JHorwitz1011/F.R.E.T.-Board/boards/shield/v1/output/v3/v1.png

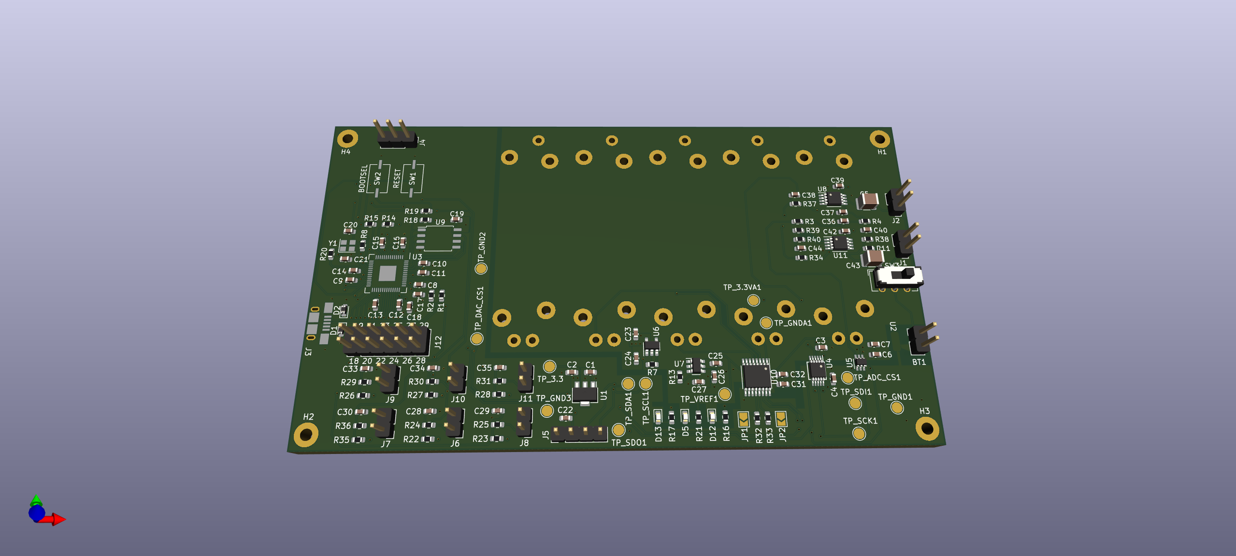
boards/shield/v1/output/v3/v1.png
