JHorwitz1011/F.R.E.T.-Board/README.md

# F.R.E.T.-Board

## Fall '23 Senior Project

Jim Horwitz, Julia Brubach, Peter Buglewicz
