JHorwitz1011/F.R.E.T.-Board/code/examples/filtering/fullFilterBoth.png

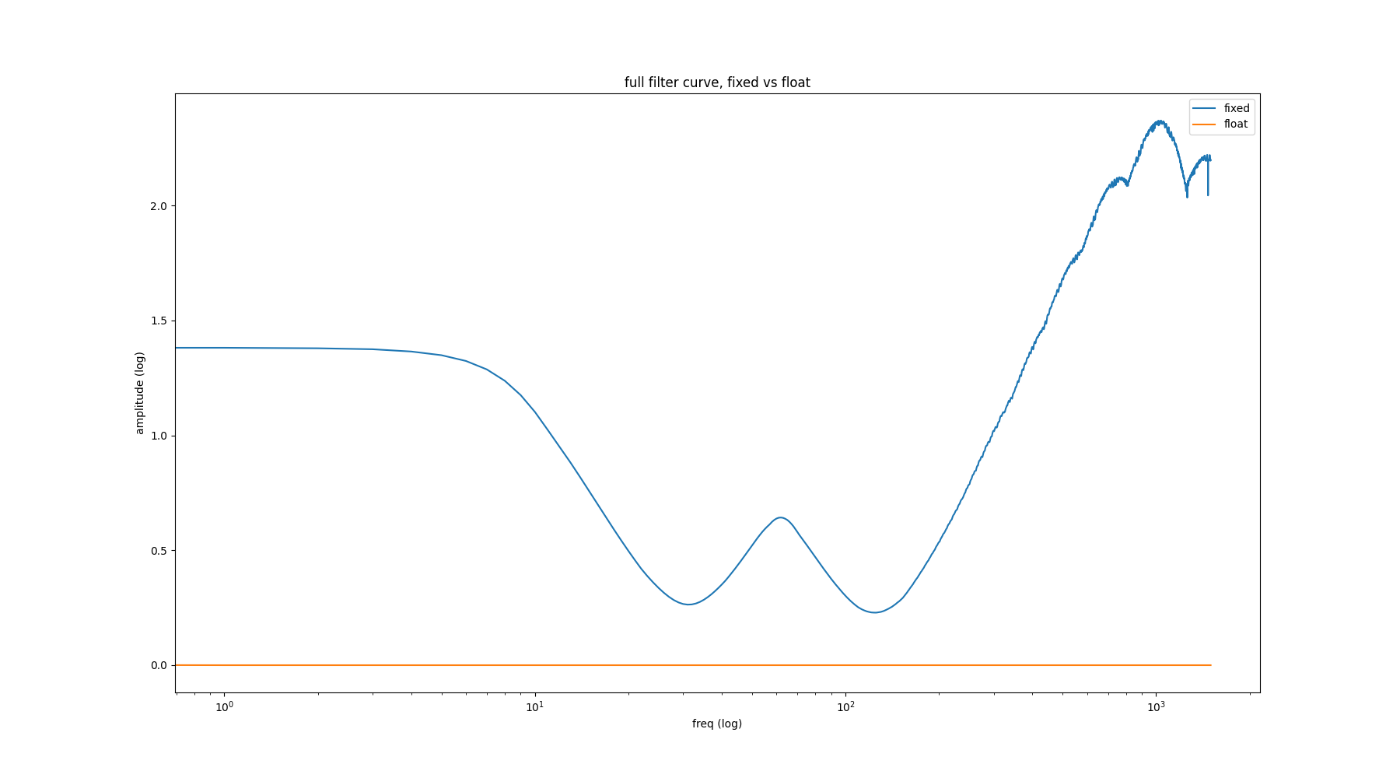
code/examples/filtering/fullFilterBoth.png
