JHorwitz1011/F.R.E.T.-Board/code/examples/filtering/fullFilterFixed.png

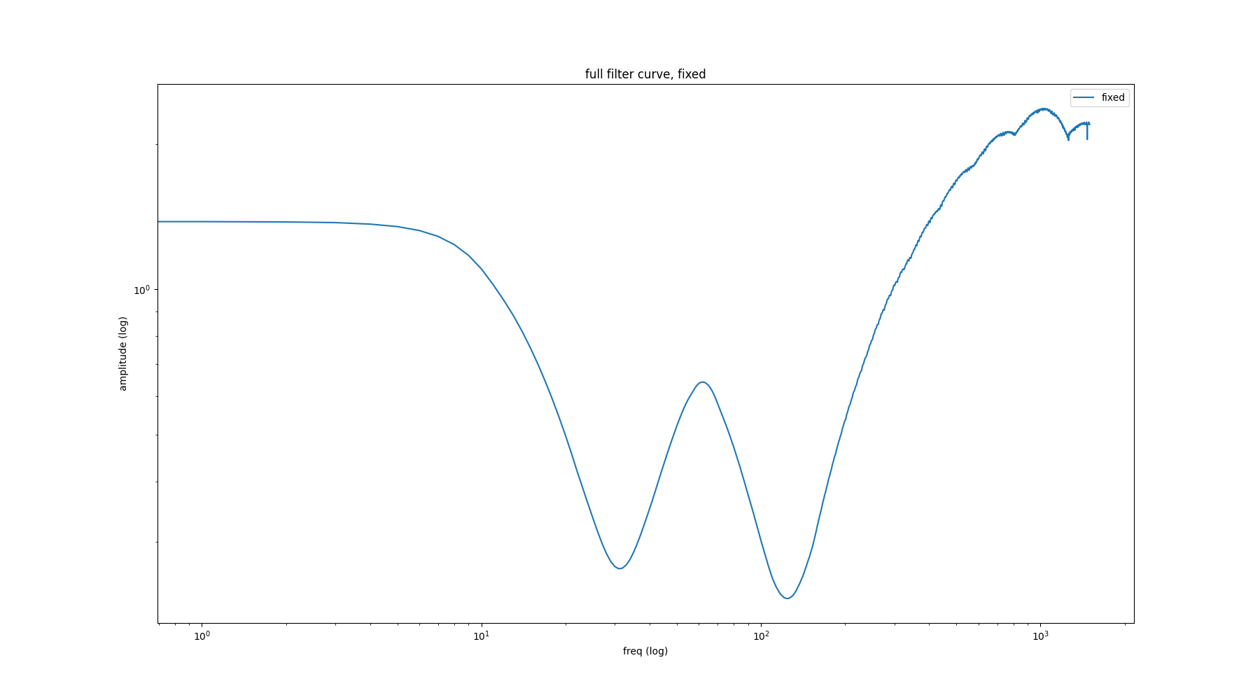
code/examples/filtering/fullFilterFixed.png
