JHorwitz1011/F.R.E.T.-Board/code/examples/filtering/fullFilterFloat.png

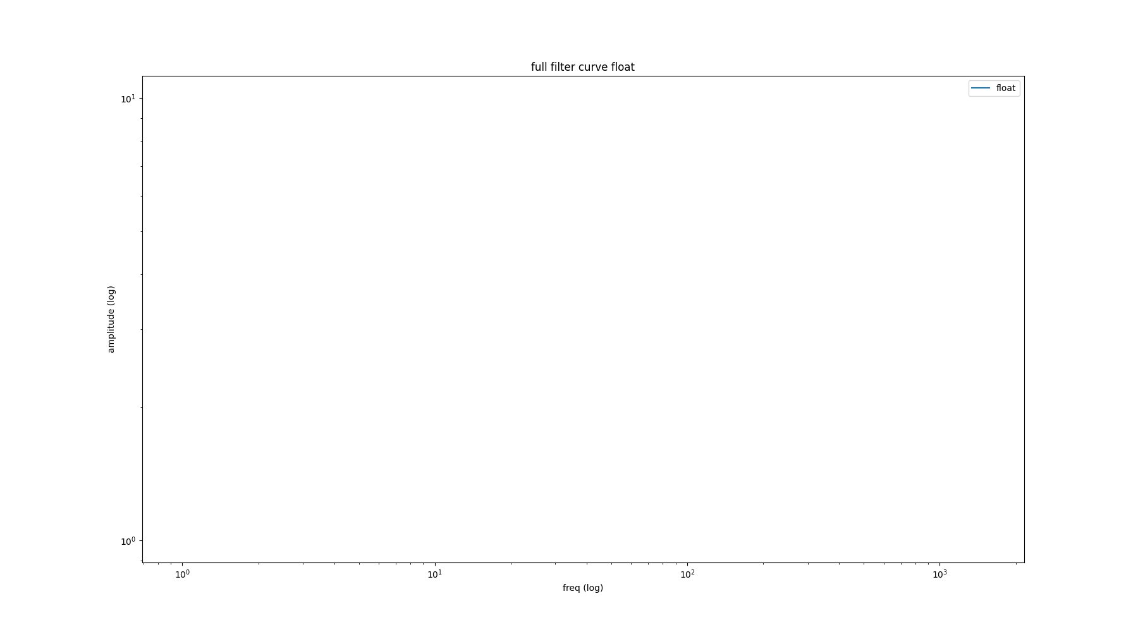
code/examples/filtering/fullFilterFloat.png
