JHorwitz1011/F.R.E.T.-Board/code/examples/filtering/individualResponsesBoth.png

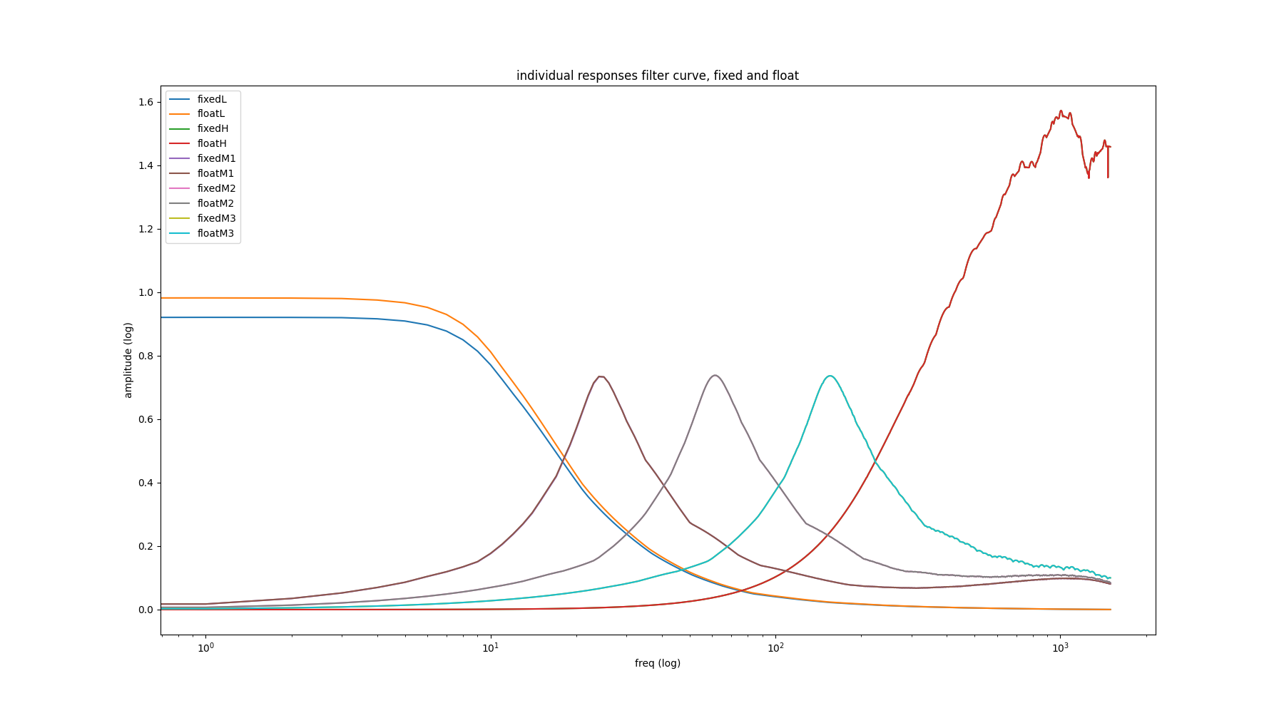
code/examples/filtering/individualResponsesBoth.png
