JHorwitz1011/F.R.E.T.-Board/code/examples/filtering/individualResponsesFixed.png

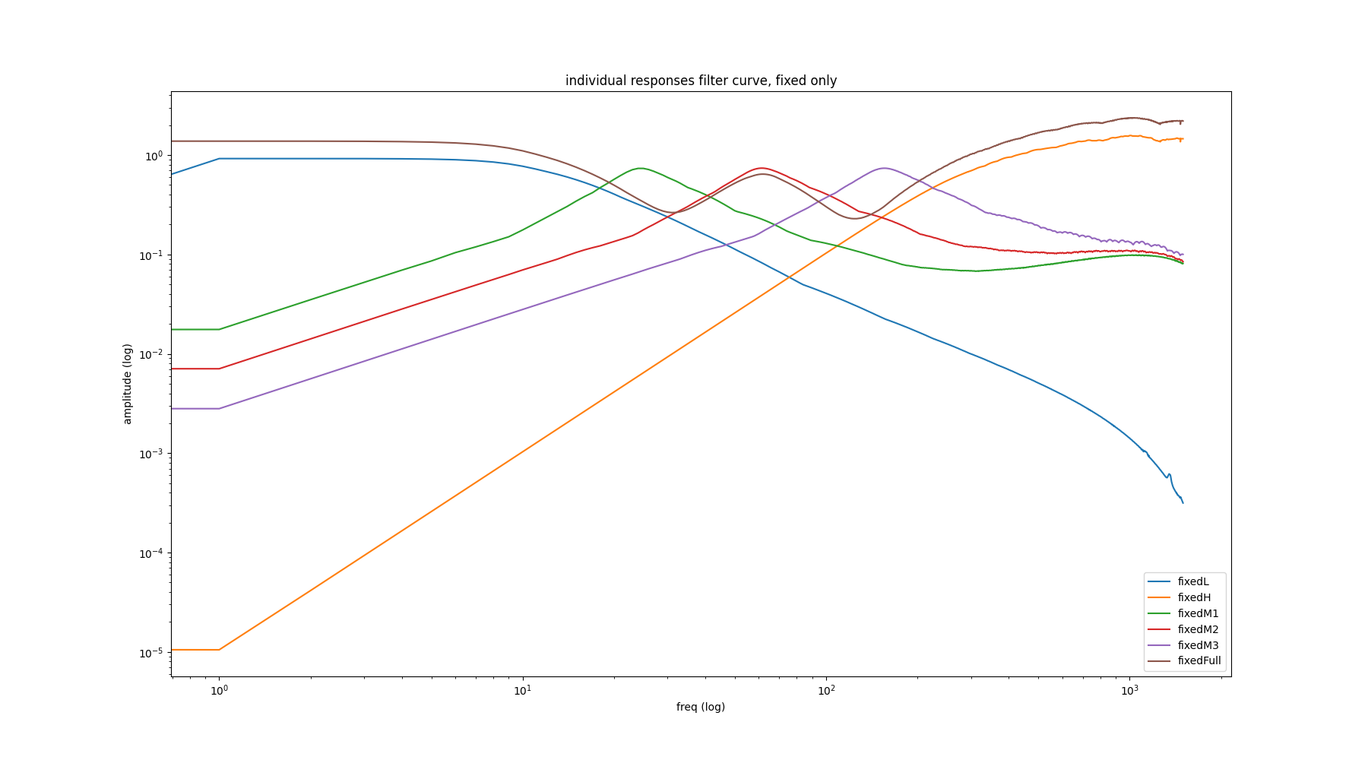
code/examples/filtering/individualResponsesFixed.png
