JHorwitz1011/F.R.E.T.-Board/code/examples/filtering/individualResponsesFloat.png

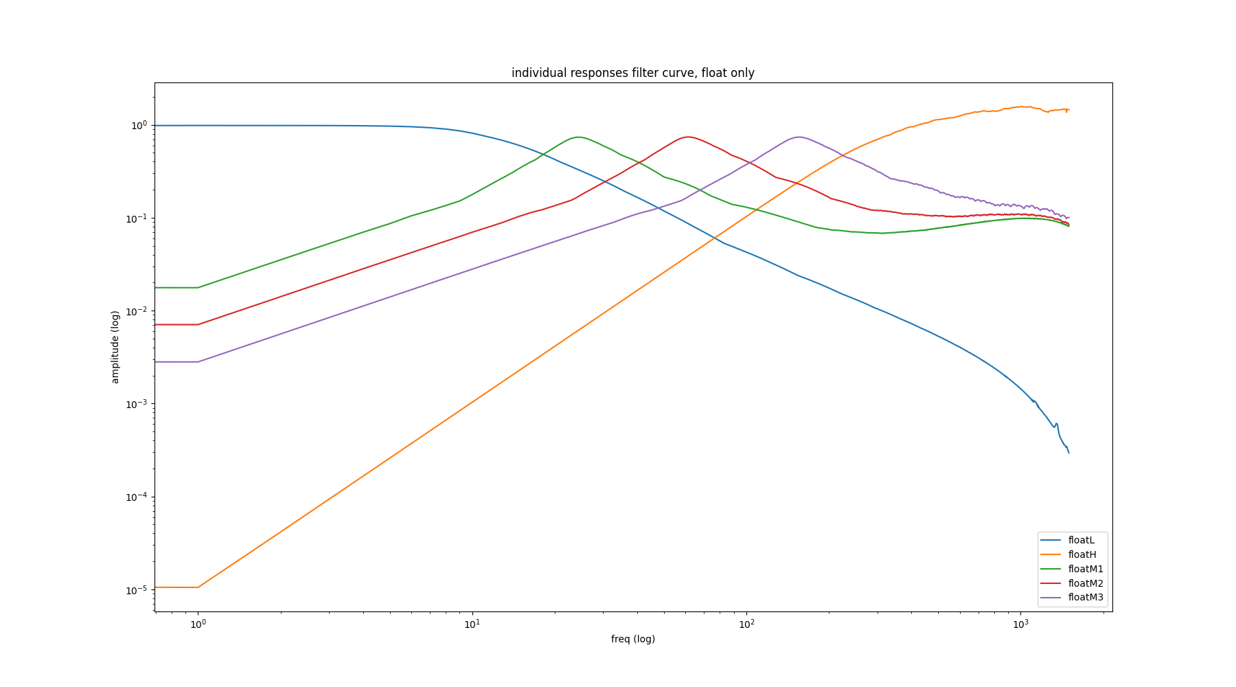
code/examples/filtering/individualResponsesFloat.png
