JHorwitz1011/F.R.E.T.-Board/boards/shield/v1/output/v3/v1.pdf

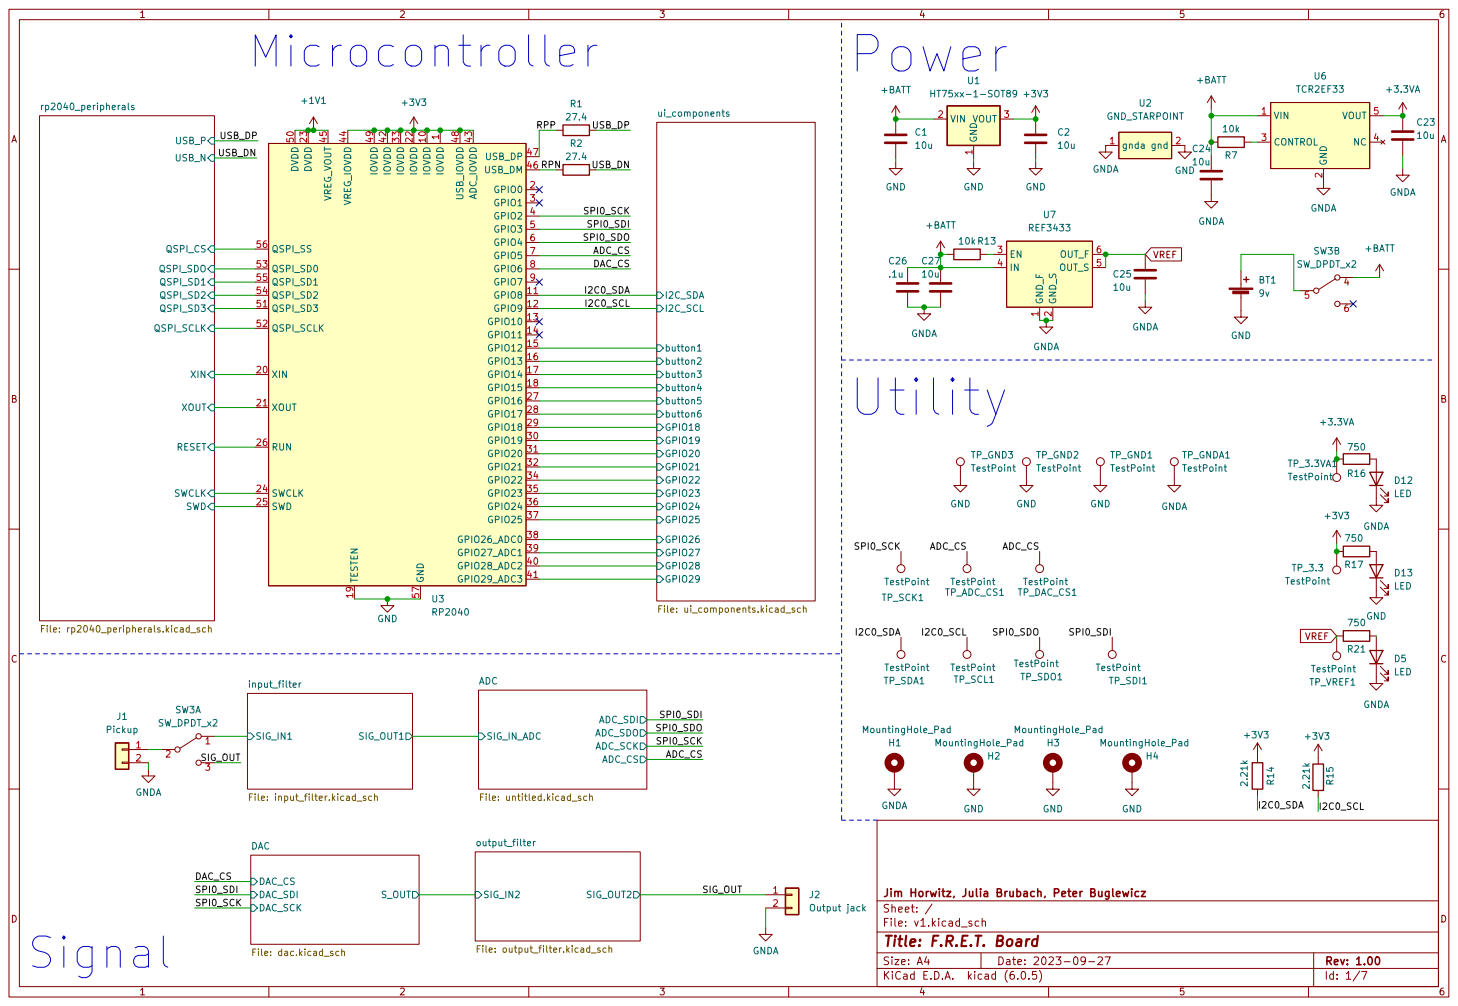
[picture p8: page 1]

2 CONTROL 3 NC 4 VOUT 5 U6 TCR2EF33 GNDA D13
+BATTR7

1 IOVDD 10 GPIO8 11 GPIO9 12 GPIO10 13 GPIO11 14 GPIO12 15 GPIO13 16 GPIO14 17 GPIO15 18 TESTEN 19 GPIO0 2 XIN 20 XOUT 21 IOVDD 22 DVDD 23 SWCLK 24 SWD 25 RUN 26 GPIO16 27 GPIO17 28 GPIO18 29 GPIO1 3 GPIO19 30 GPIO20 31 GPIO21 32 IOVDD 33 GPIO22 34 GPIO23 35 GPIO24 36 GPIO25 37 GPIO26_ADC0 38 GPIO27_ADC1 39 GPIO2 4 GPIO28_ADC2 40 GPIO29_ADC3 41 IOVDD 42 ADC_IOVDD 43 VREG_IOVDD 44 VREG_VOUT 45 USB_DM 46 USB_DP 47 USB_IOVDD 48 IOVDD 49 GPIO3 5 DVDD 50 QSPI_SD3 51 QSPI_SCLK 52 QSPI_SD0 53 QSPI_SD2 54 QSPI_SD1 55 QSPI_SS 56 GND 57 GPIO4 6 GPIO5 7 GPIO6 8 GPIO7 9 U3RP2040 +3V3 TP_3.3VA1 TestPoint VREF VREF ADC_CS

QSPI_SD2 QSPI_SD3 QSPI_SD1 QSPI_SCLK QSPI_CS
SWCLK RESET XOUT XIN QSPI_SDO

File: v1.kicad_sch Sheet: / Jim Horwitz, Julia Brubach, Peter Buglewicz SWD

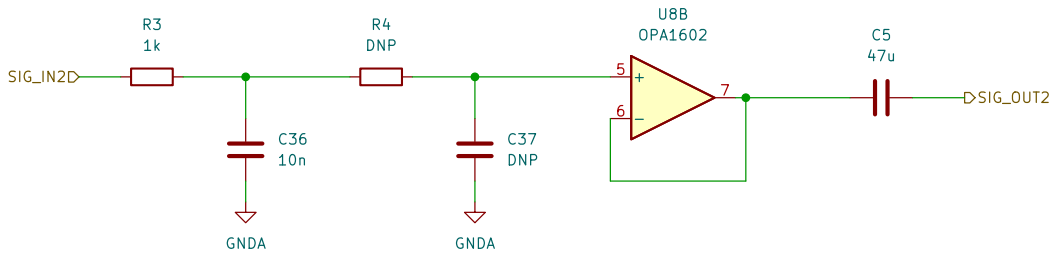
[picture p9: page 2]

Jim Horwitz, Julia Brubach, Peter Buglewicz
Sheet: /output_filter/
File: output_filter.kicad_sch
Id: 2/7 Title: F.R.E.T. Board

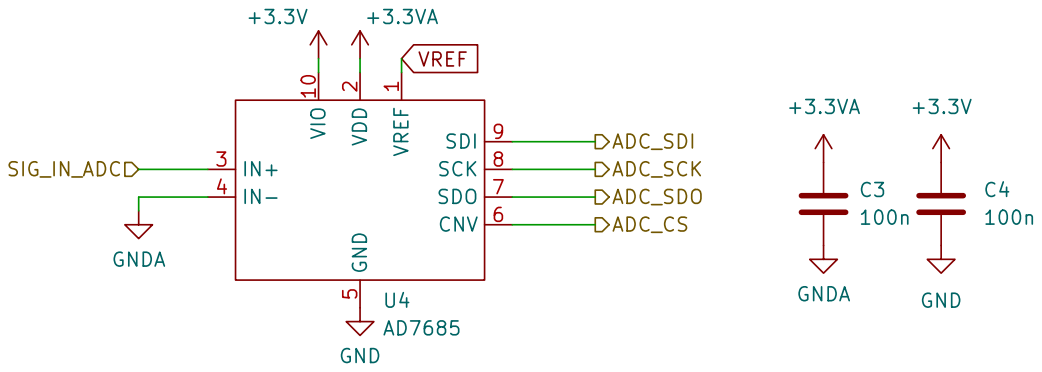
[picture p10: page 3]

File: untitled.kicad_sch Sheet: /ADC/ Jim Horwitz, Julia Brubach, Peter Buglewicz VREF

5 CNV 6 SDO 7 SCK 8 SDI 9 U4AD7685 GND

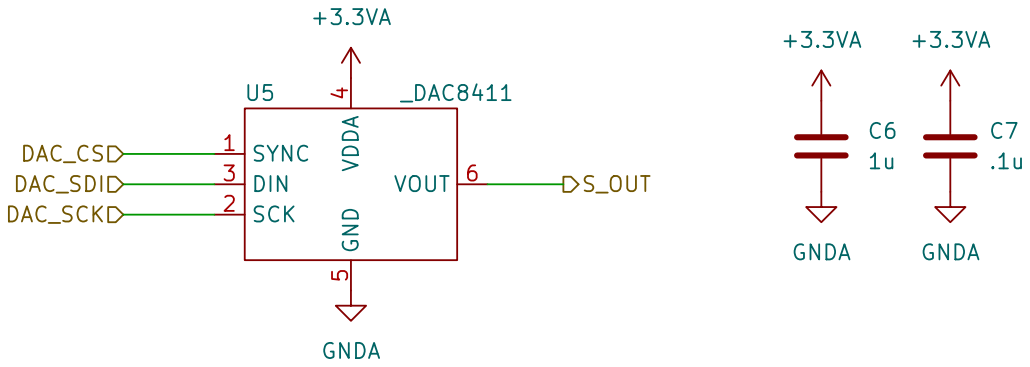
[picture p11: page 4]

File: dac.kicad_sch Sheet: /DAC/ Jim Horwitz, Julia Brubach, Peter Buglewicz GNDA

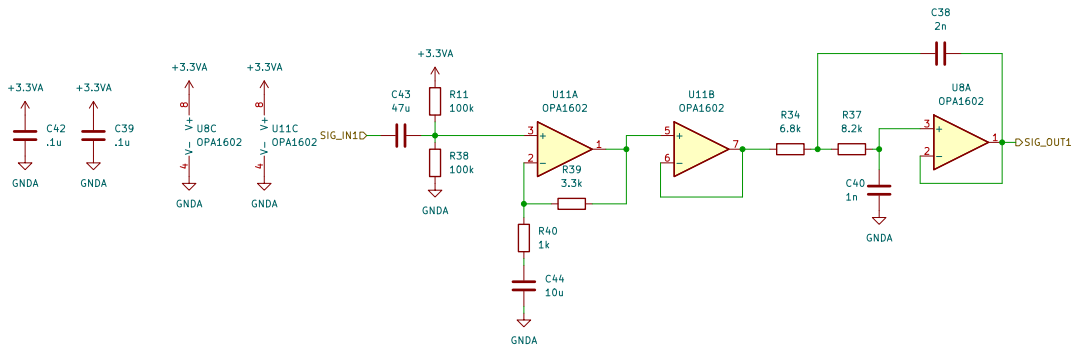
[picture p12: page 5]

Jim Horwitz, Julia Brubach, Peter Buglewicz
Sheet: /input_filter/
File: input_filter.kicad_sch
Id: 6/7 Title: F.R.E.T. Board

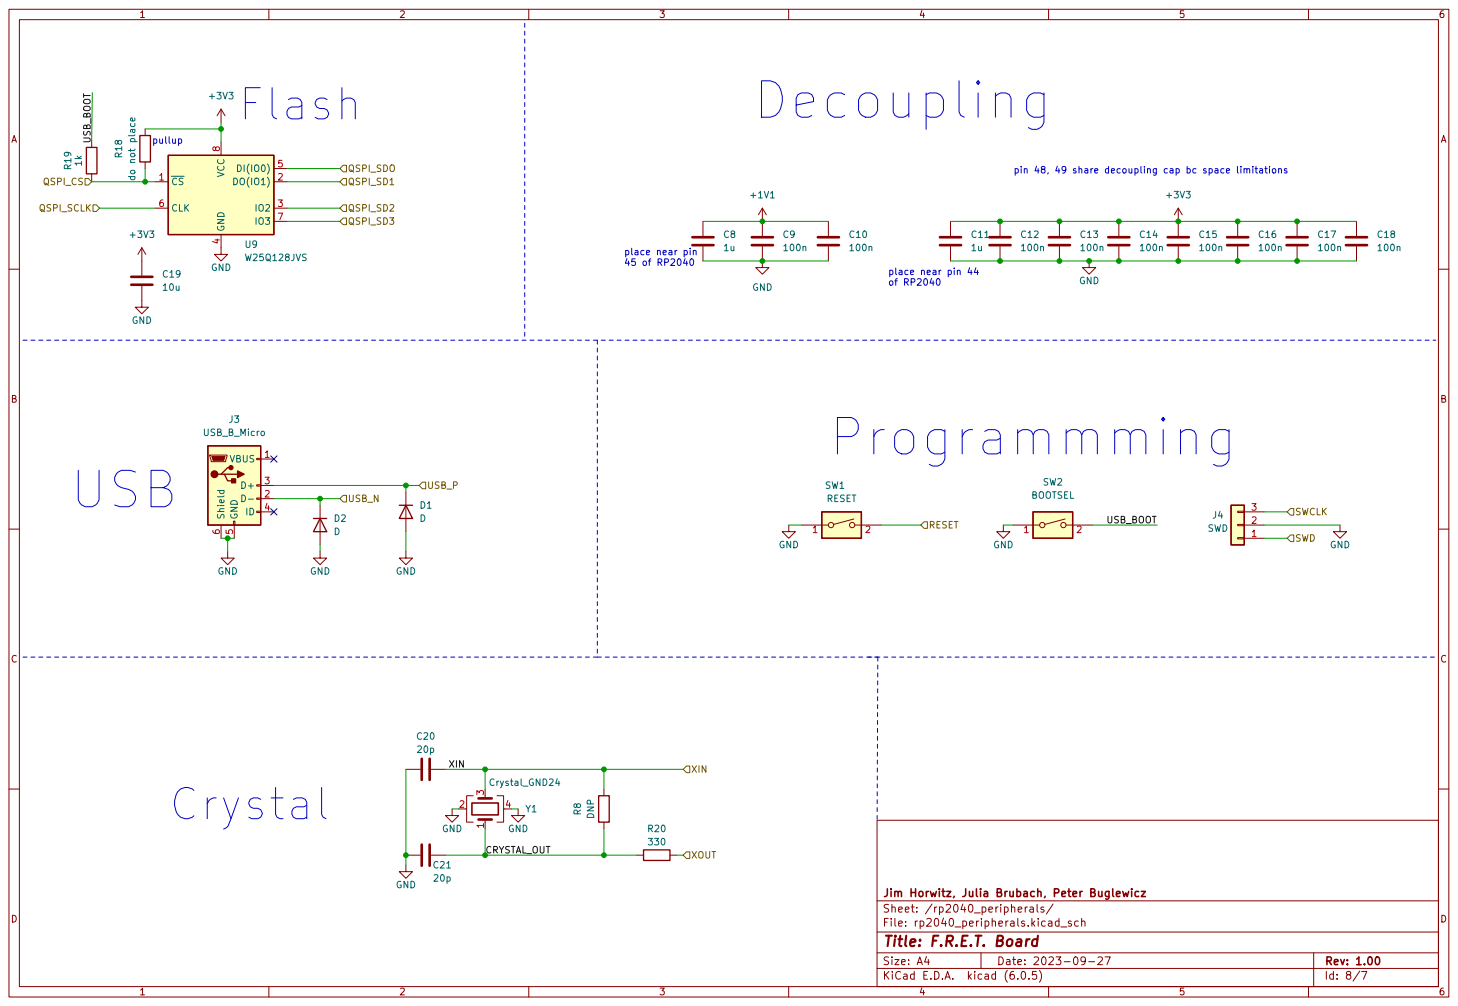
[picture p13: page 6]

pin 48, 49 share decoupling cap bc space limitations

place near pin 45 of RP2040

place near pin 44 of RP2040

Jim Horwitz, Julia Brubach, Peter Buglewicz
Sheet: /rp2040_peripherals/
File: rp2040_peripherals.kicad_sch
Id: 8/7 Title: F.R.E.T. Board

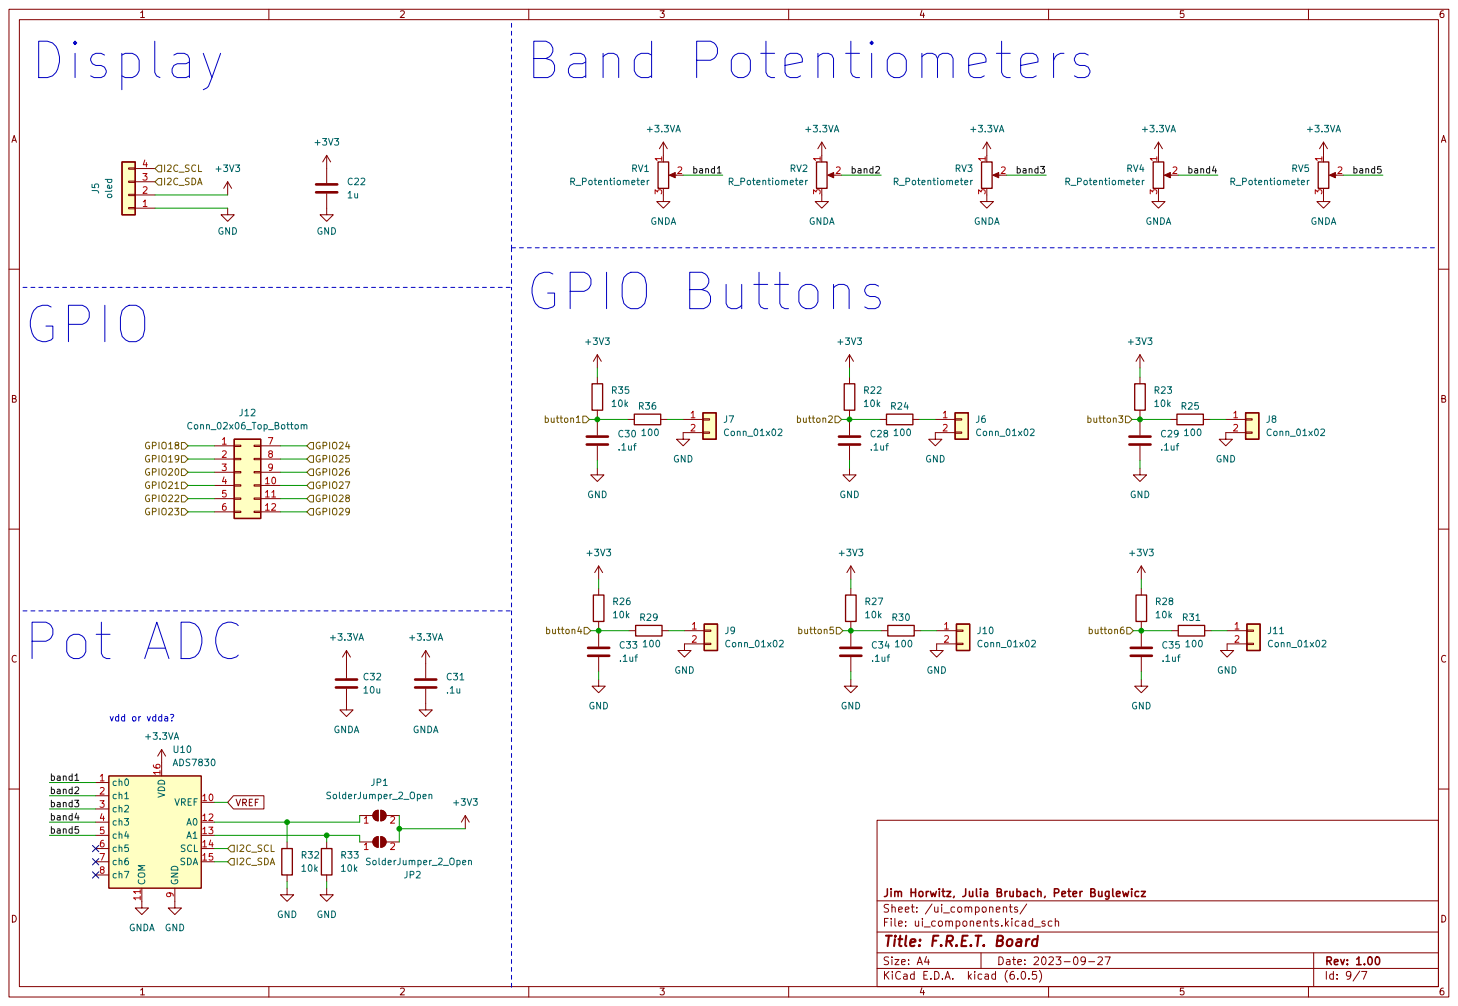
[picture p14: page 7]

Jim Horwitz, Julia Brubach, Peter Buglewicz
Sheet: /ui_components/
File: ui_components.kicad_sch
Id: 9/7 Title: F.R.E.T. Board
