JHorwitz1011/F.R.E.T.-Board/boards/shield/v1/v2.pdf

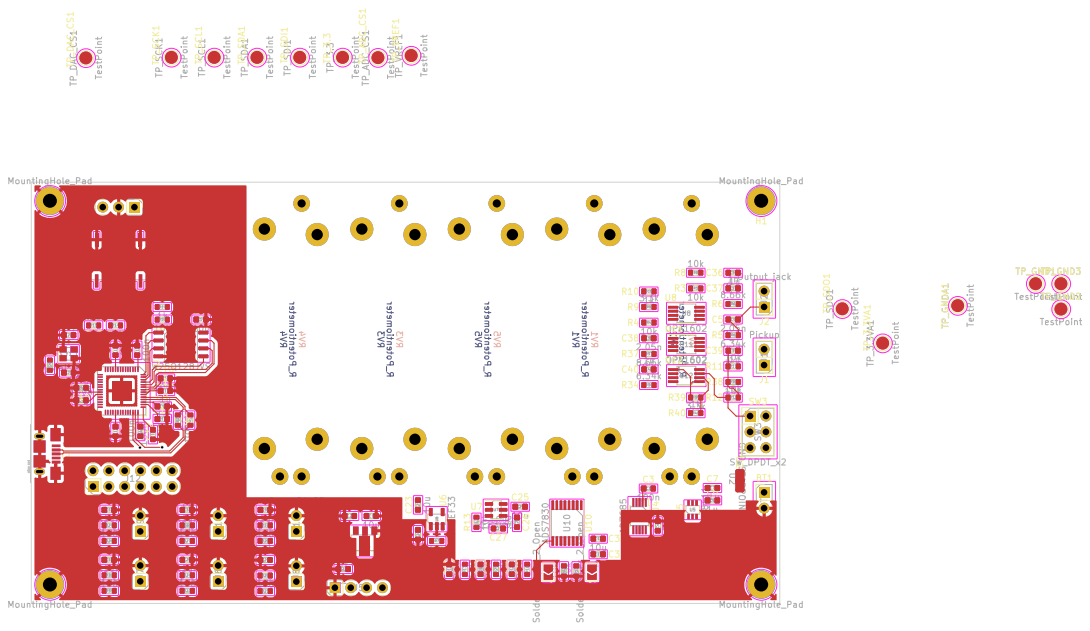
[picture p15: page 1]
