JHorwitz1011/F.R.E.T.-Board/boards/shield/v1/output/v0/v0.pdf

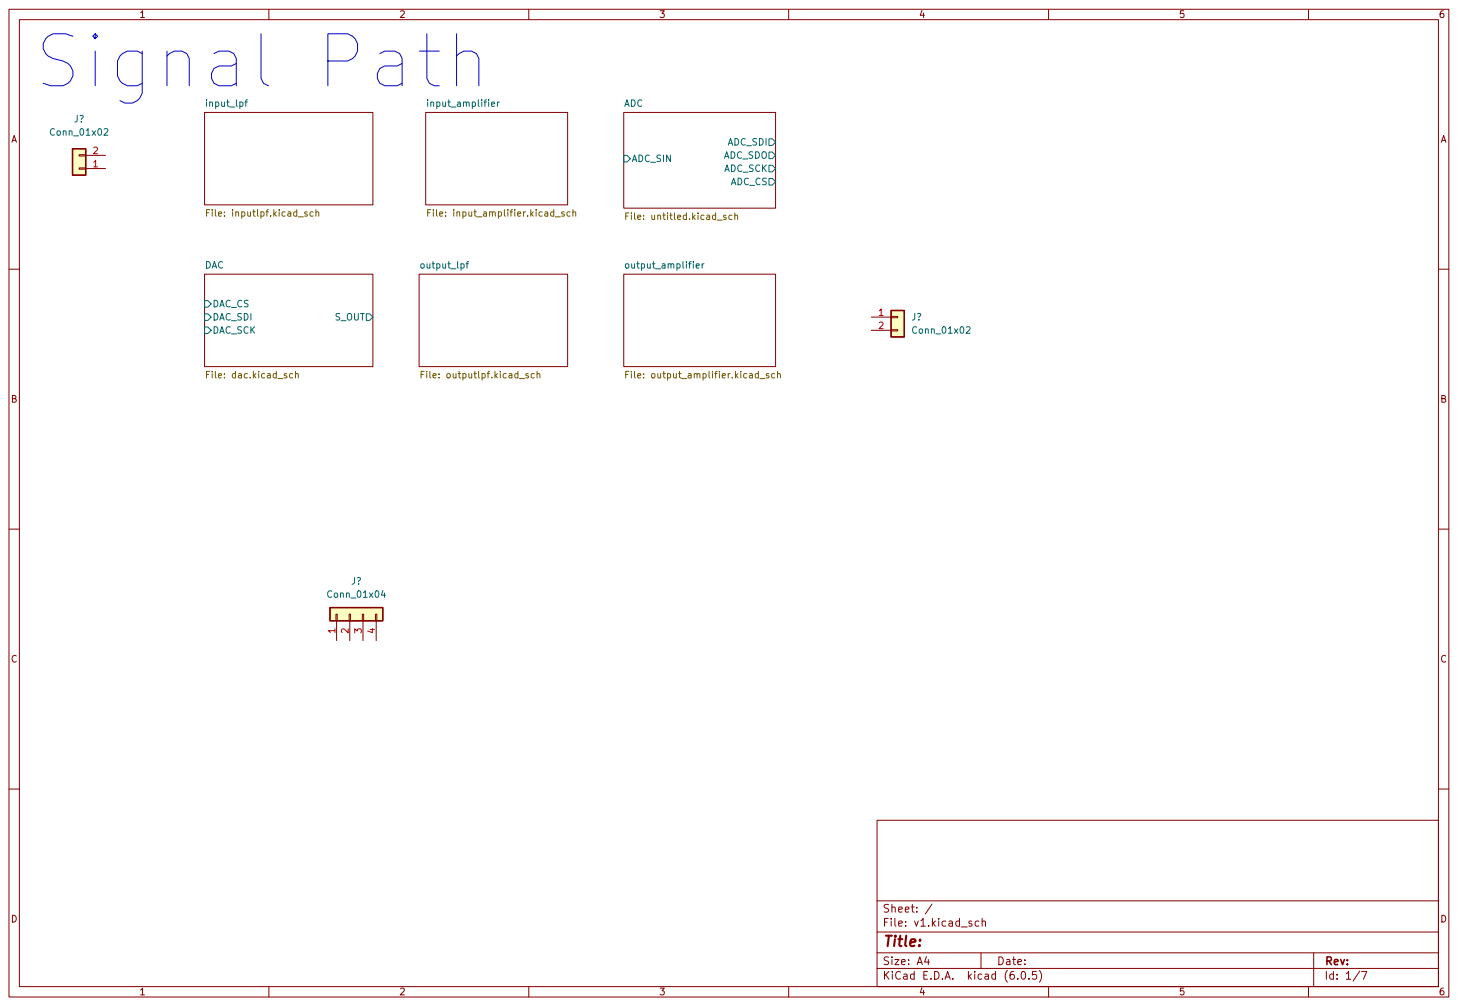
[picture p16: page 1]

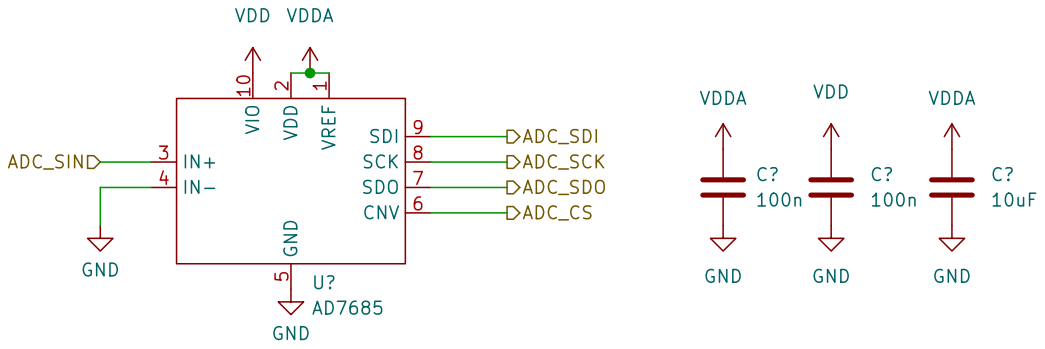
[picture p17: page 2]

5 CNV 6 SDO 7 SCK 8 SDI 9 U?AD7685 GND

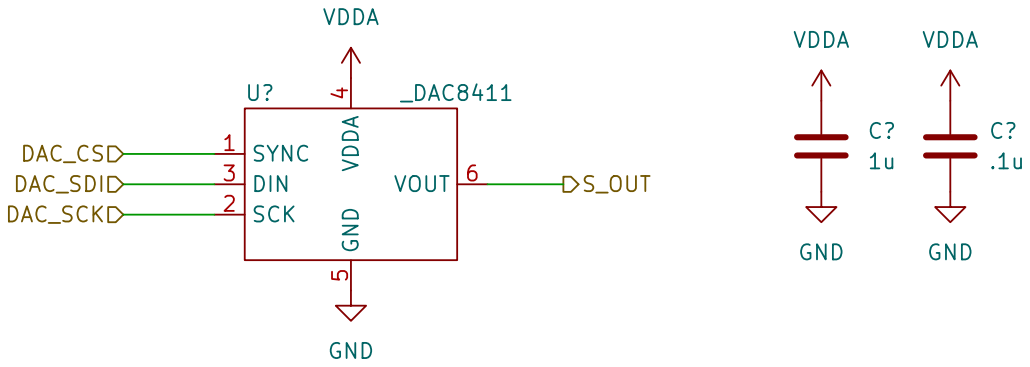
[picture p18: page 3]

File: dac.kicad_sch Sheet: /DAC/ GND

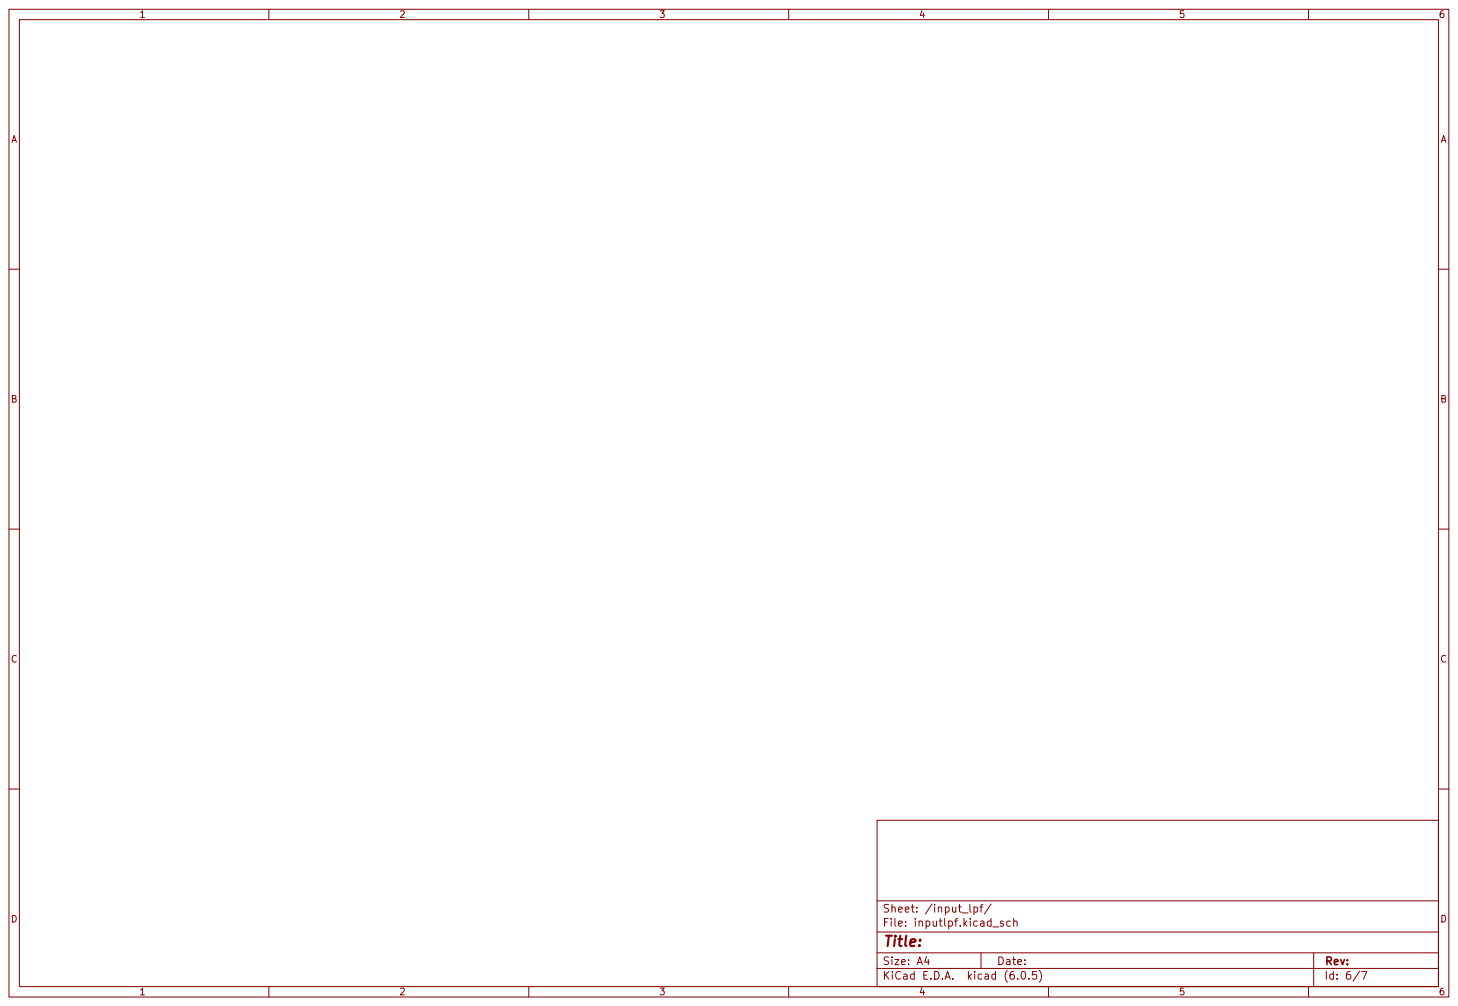
[picture p19: page 4]

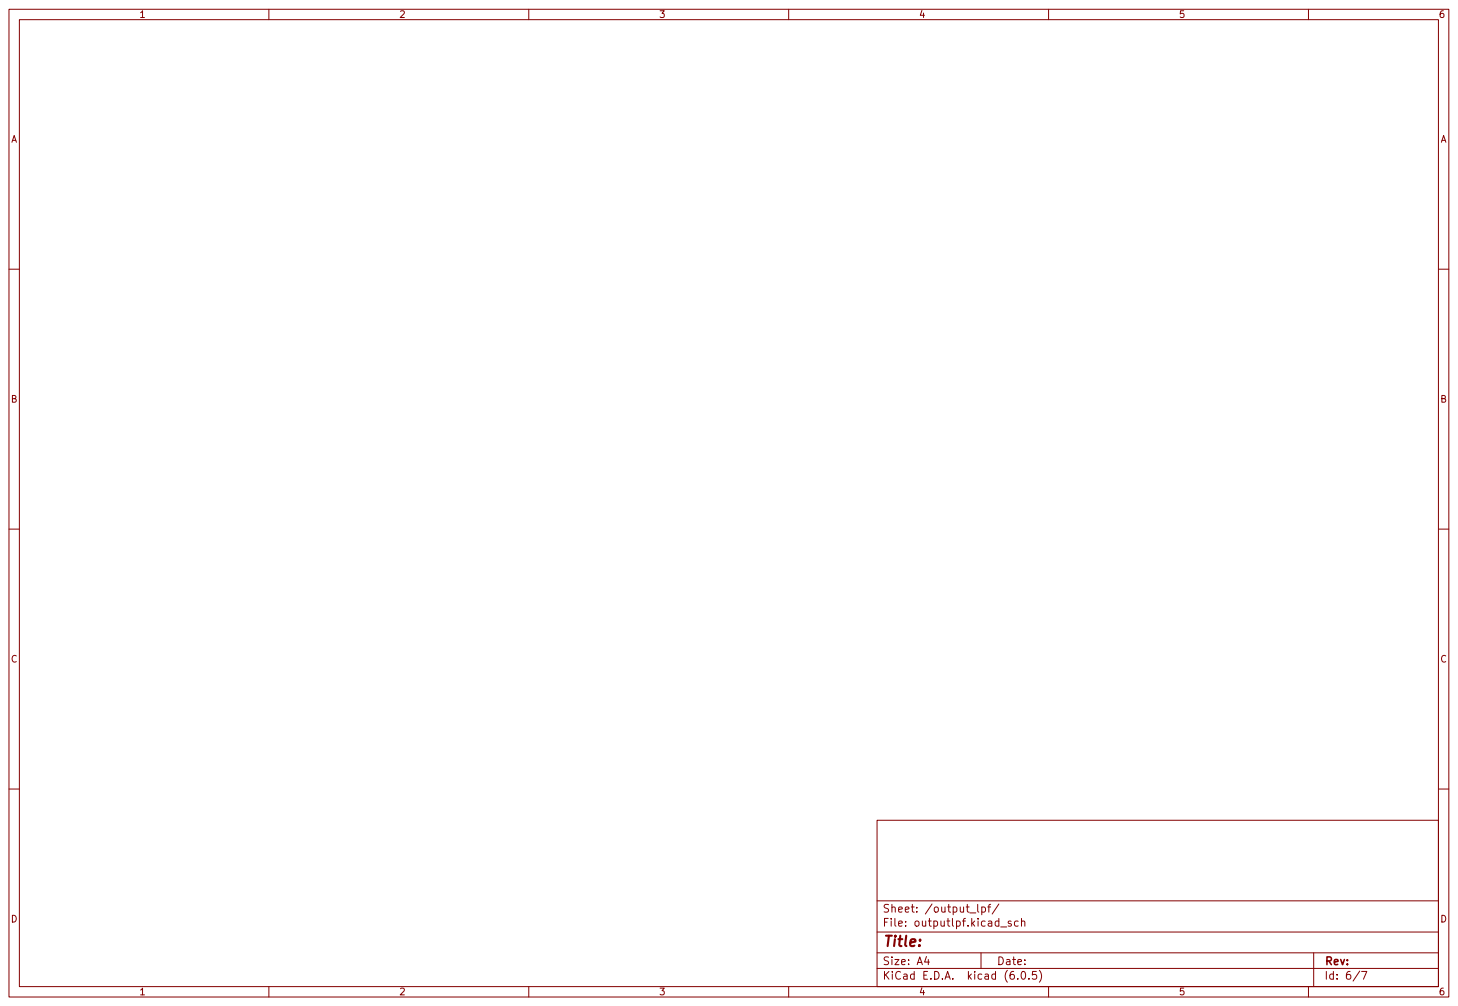
[picture p20: page 5]

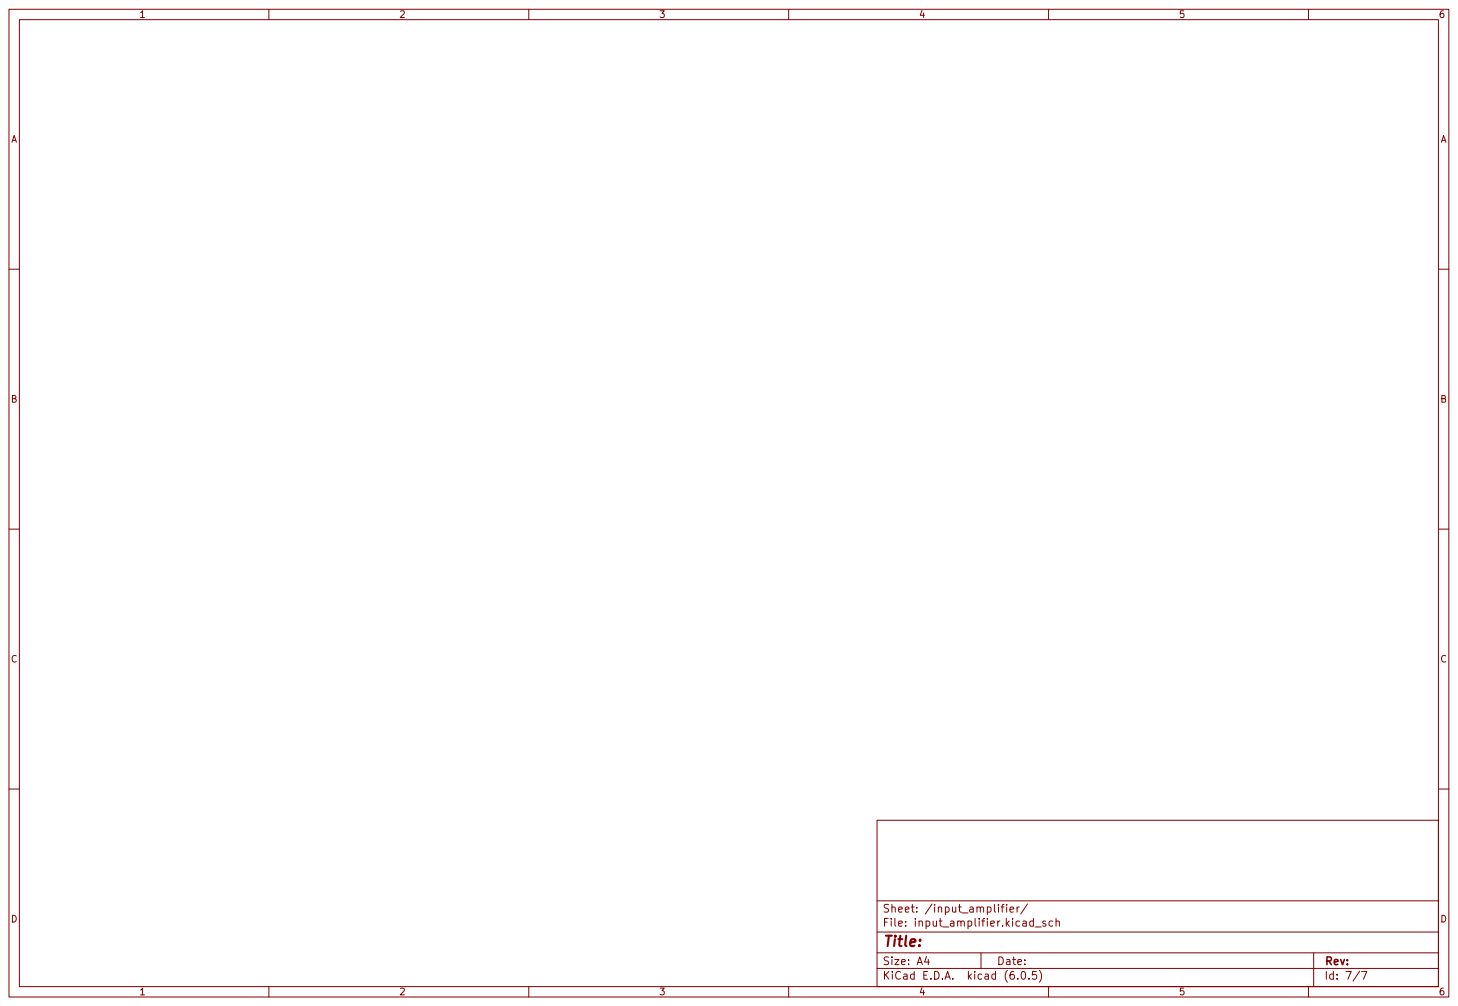
[picture p21: page 6]

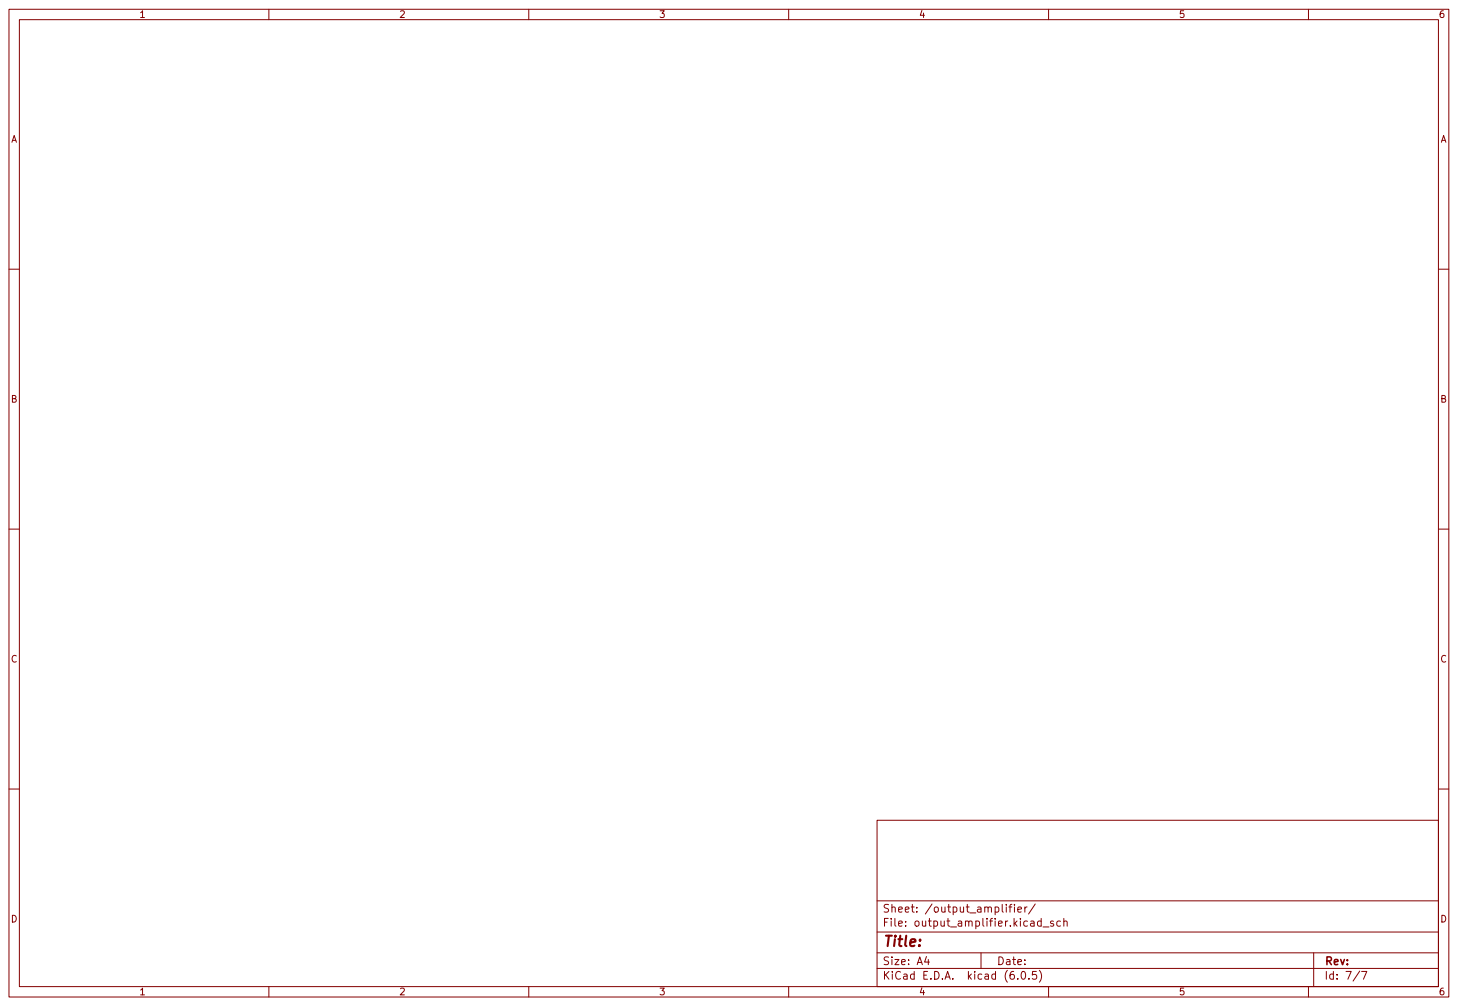
[picture p22: page 7]
