JHorwitz1011/F.R.E.T.-Board/boards/shield/v1/output/v1/v1-B_Cu.pdf

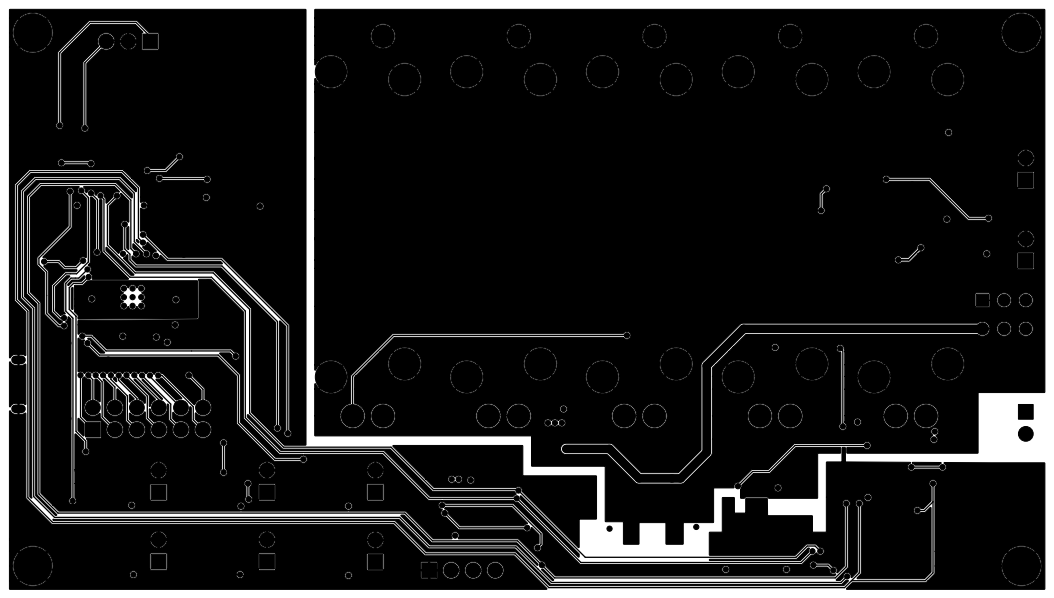
[picture p23: page 1]
