JHorwitz1011/F.R.E.T.-Board/boards/shield/v1/output/v1/v1-F_Cu.pdf

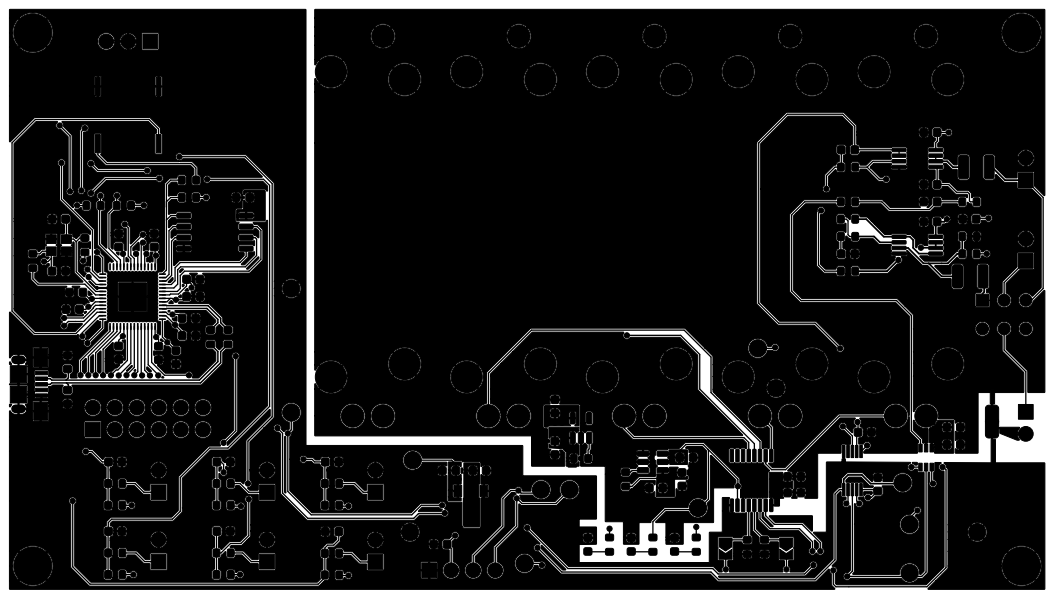
[picture p25: page 1]
