JHorwitz1011/F.R.E.T.-Board/boards/shield/v1/output/v1/v1-F_Mask.pdf

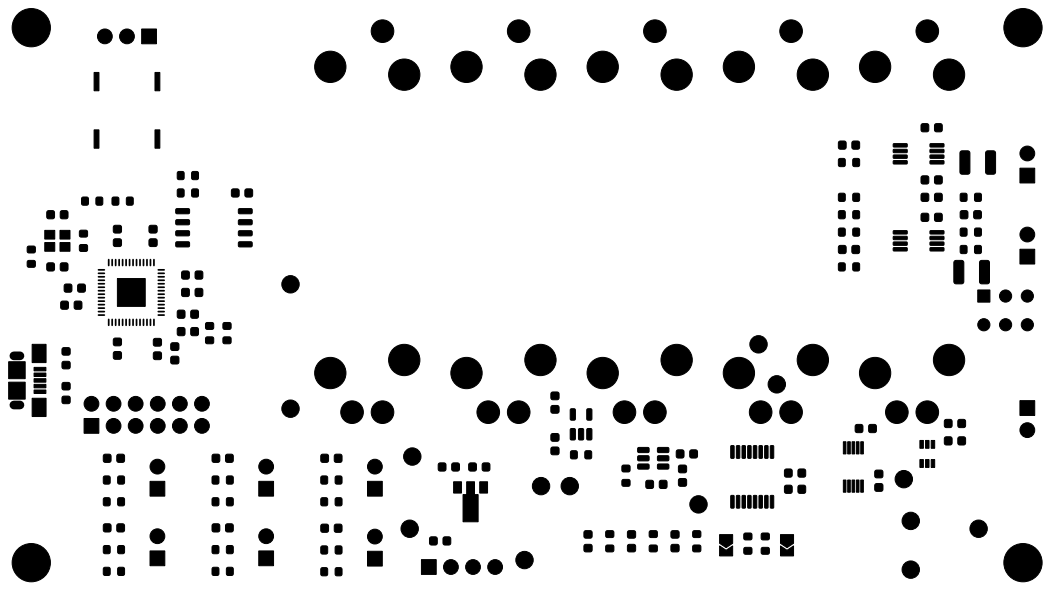
[picture p26: page 1]
