JHorwitz1011/F.R.E.T.-Board/boards/shield/v1/output/v1/v1-F_Paste.pdf

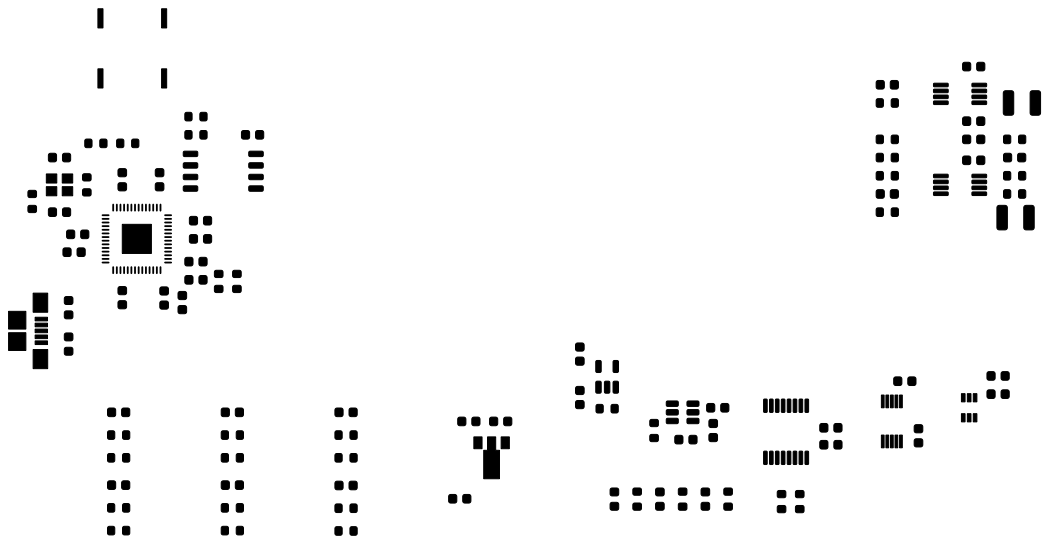
[picture p27: page 1]
