JHorwitz1011/F.R.E.T.-Board/boards/shield/v1/output/v1/v1-F_Silkscreen.pdf

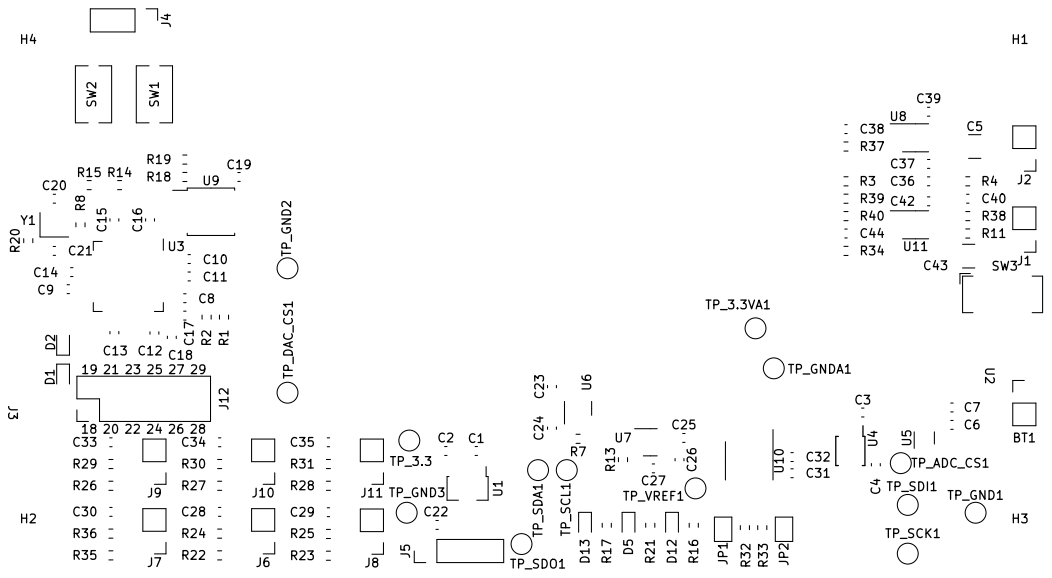
[picture p28: page 1]
