JHorwitz1011/F.R.E.T.-Board/boards/shield/v1/output/v1/v1-In1_Cu.pdf

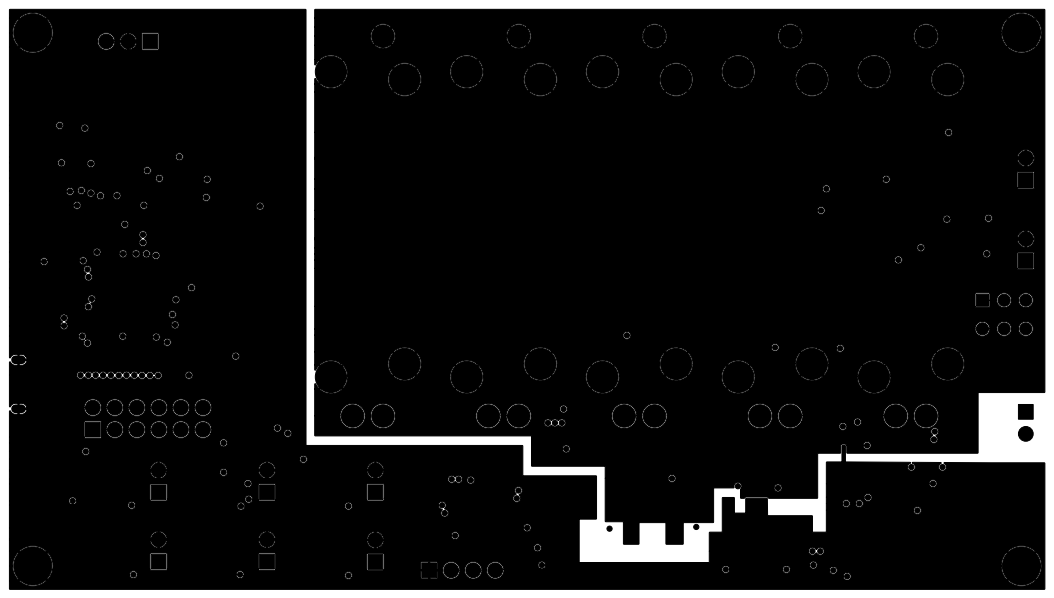
[picture p29: page 1]
