JHorwitz1011/F.R.E.T.-Board/boards/shield/v1/output/v1/v1-In2_Cu.pdf

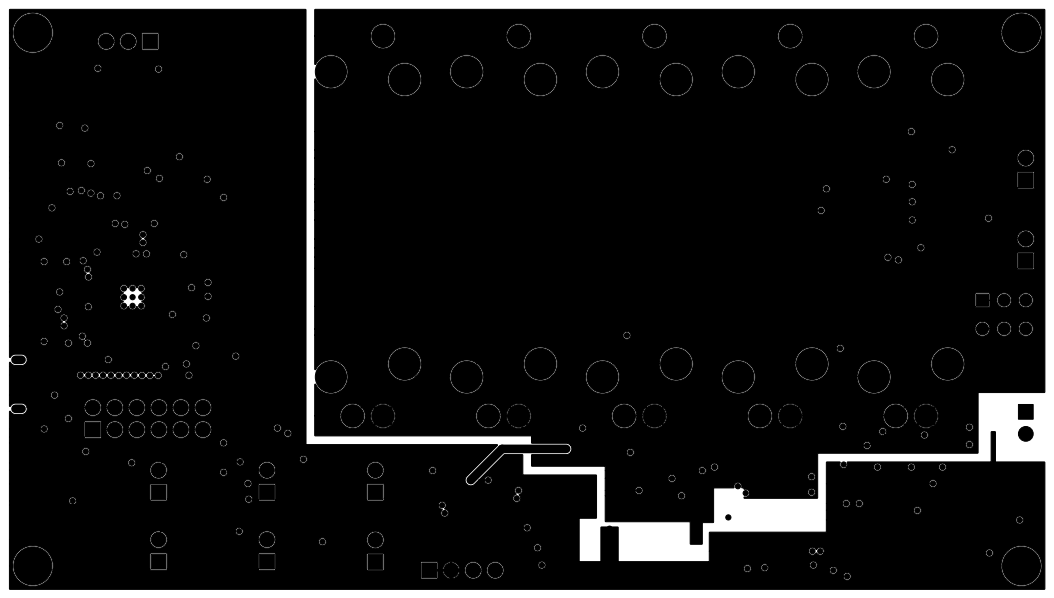
[picture p30: page 1]
