JHorwitz1011/F.R.E.T.-Board/boards/shield/v1/v1.kicad_pcb

## KiCad design boards/shield/v1/v1.kicad_pcb (2023-10-31)

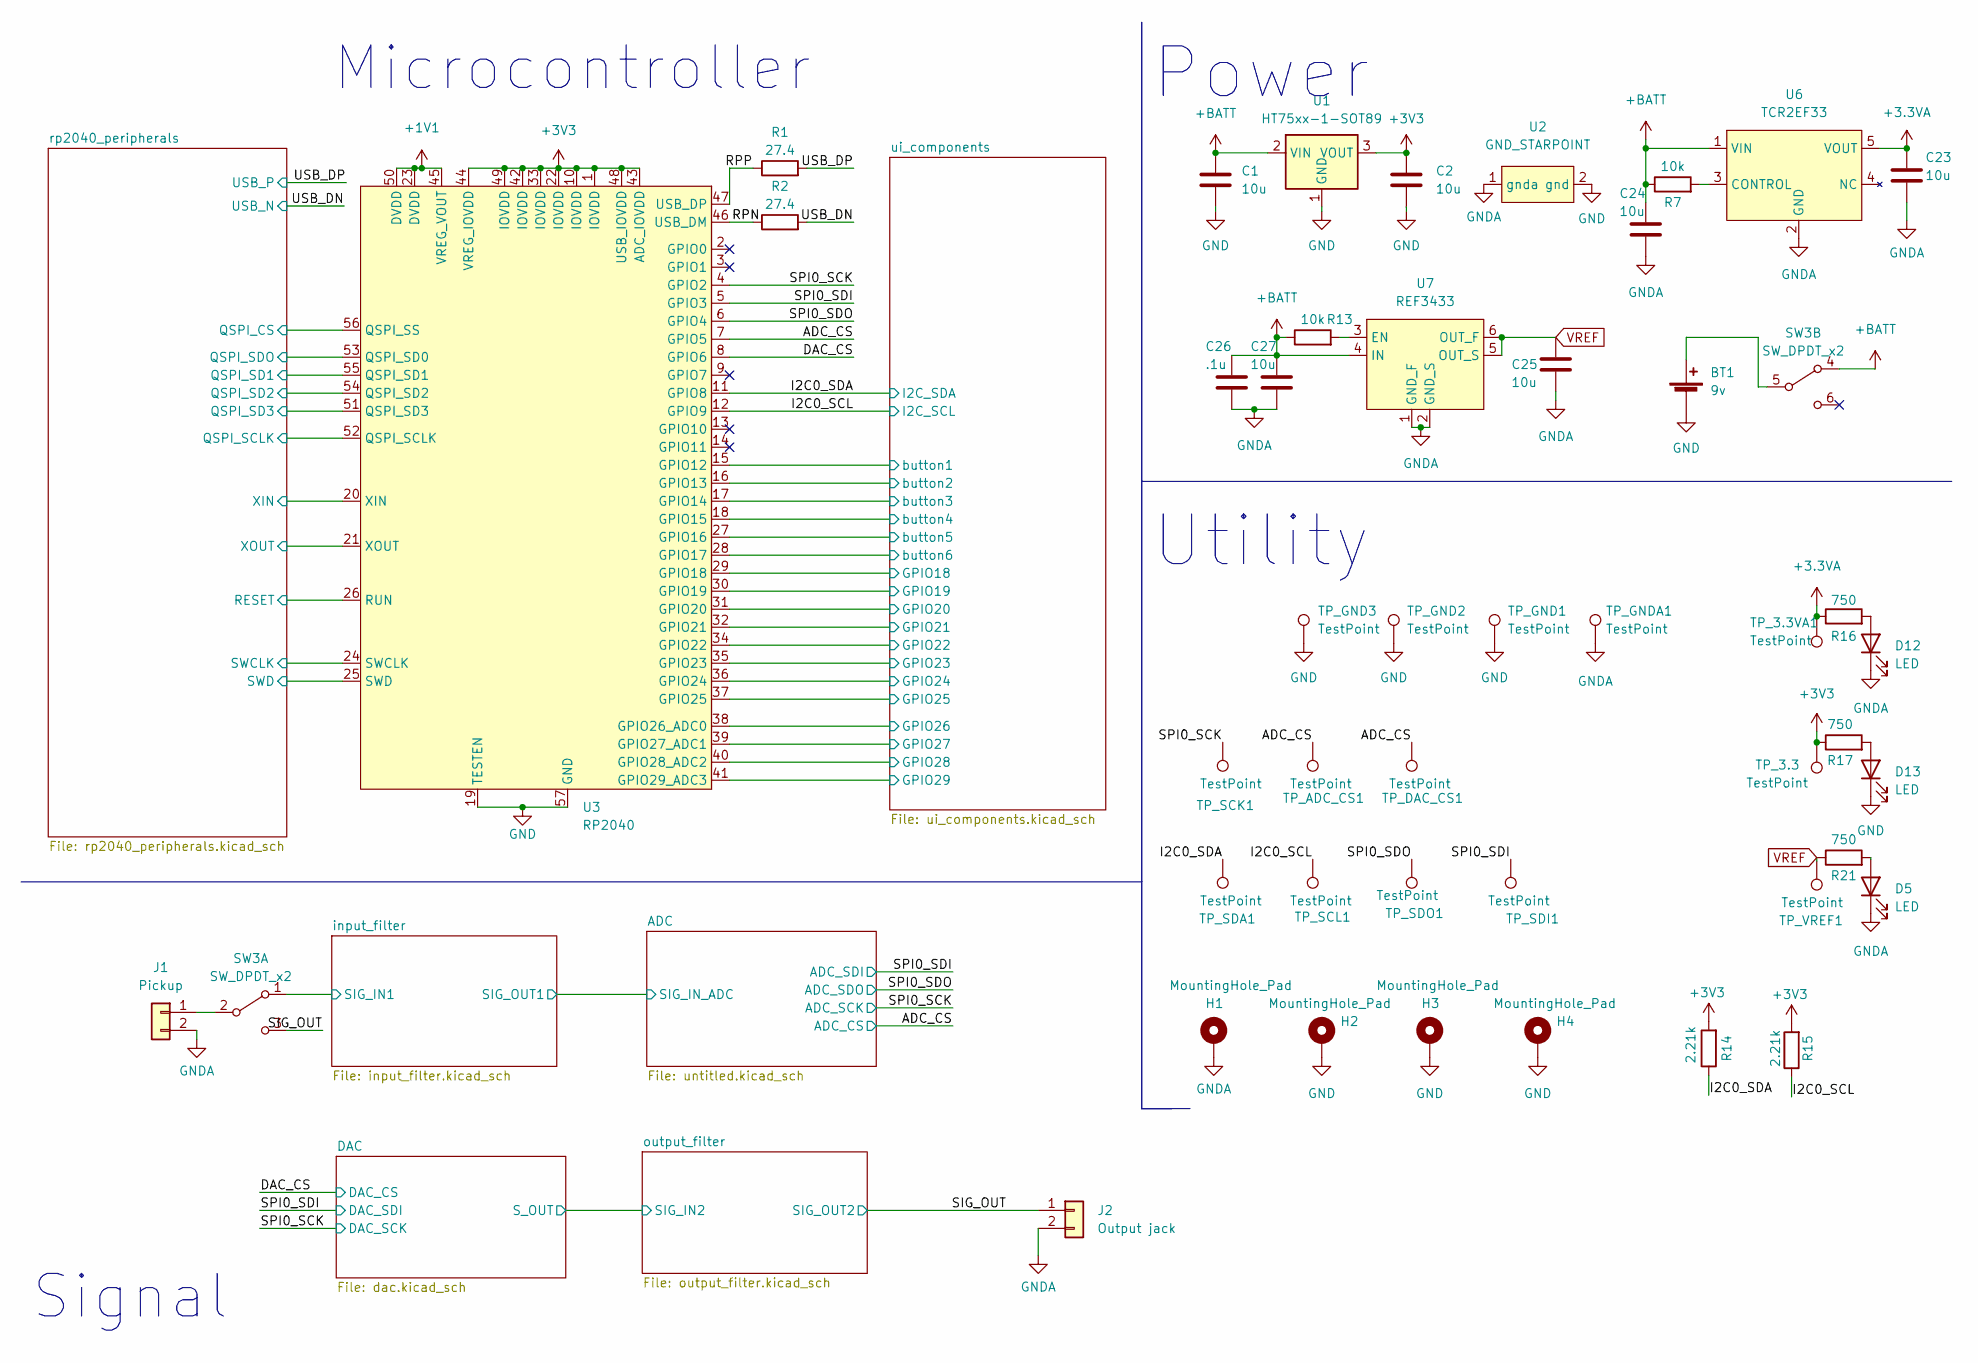
[picture p31: schematic v1.kicad_sch, F.R.E.T. Board]

Parts:
BT1: 9v; PinHeader_1x02_P2.54mm_Vertical
C1, C2, C23, C24, C25, C27: 10u; C_0603_1608Metric
C26: .1u; C_0603_1608Metric
D5, D12, D13: LED; LED_0603_1608Metric
H1, H2, H3, H4: MountingHole_Pad; MountingHole_2.2mm_M2_Pad
J1: Pickup; PinHeader_1x02_P2.54mm_Vertical
J2: Output jack; PinHeader_1x02_P2.54mm_Vertical
R1, R2: 27.4; R_0603_1608Metric
R7, R13: 10k; R_0603_1608Metric
R14, R15: 2.21k; R_0603_1608Metric
R16, R17, R21: 750; R_0603_1608Metric
SW3: SW_DPDT_x2; SW_CuK_JS202011CQN_DPDT_Straight
TP_3.3, TP_3.3VA1: TestPoint; TestPoint_Pad_D2.0mm
TP_ADC_CS1: TestPoint; TestPoint_Pad_D2.0mm
TP_DAC_CS1: TestPoint; TestPoint_Pad_D2.0mm
TP_GND1, TP_GND2, TP_GND3: TestPoint; TestPoint_Pad_D2.0mm
TP_GNDA1: TestPoint; TestPoint_Pad_D2.0mm
TP_SCK1: TestPoint; TestPoint_Pad_D2.0mm
TP_SCL1: TestPoint; TestPoint_Pad_D2.0mm
TP_SDA1: TestPoint; TestPoint_Pad_D2.0mm
TP_SDI1: TestPoint; TestPoint_Pad_D2.0mm
TP_SDO1: TestPoint; TestPoint_Pad_D2.0mm
TP_VREF1: TestPoint; TestPoint_Pad_D2.0mm
U1: HT75xx-1-SOT89; SOT-89-3; LCSC Part Number C85233
U2: GND_STARPOINT
U3: RP2040; QFN-56_EP_7.75x7.75_Pitch0.4mm; LCSC Part Number C2040
U6: TCR2EF33; SOT-23-5; LCSC Part Number C843273
U7: REF3433; SOT-23-6; LCSC Part Number C882722

Connections:
+1V1: U3.23 (DVDD), U3.45 (VREG_VOUT), U3.50 (DVDD); also elsewhere on the board
+3.3VA: C23.1, R16.1, TP_3.3VA1.1, U6.5 (VOUT); also elsewhere on the board
+BATT: C1.1, C24.1, C26.1, C27.1, R7.1, R13.1, SW3.4 (A), U1.2 (VIN), U6.1 (VIN), U7.4 (IN)
/ADC_CS: TP_ADC_CS1.1, TP_DAC_CS1.1, U3.7 (GPIO5); also elsewhere on the board
/DAC_CS: U3.8 (GPIO6); also elsewhere on the board
/I2C0_SCL: R15.1, TP_SCL1.1, U3.12 (GPIO9); also elsewhere on the board
/I2C0_SDA: R14.1, TP_SDA1.1, U3.11 (GPIO8); also elsewhere on the board
/RPN: R2.1, U3.46 (USB_DM)
/RPP: R1.1, U3.47 (USB_DP)
/SIG_OUT: J2.1, SW3.3 (C); also elsewhere on the board
/SPI0_SCK: TP_SCK1.1, U3.4 (GPIO2); also elsewhere on the board
/SPI0_SDI: TP_SDI1.1, U3.5 (GPIO3); also elsewhere on the board
/SPI0_SDO: TP_SDO1.1, U3.6 (GPIO4); also elsewhere on the board
/USB_DN: R2.2; also elsewhere on the board
/USB_DP: R1.2; also elsewhere on the board
/input_filter/SIG_IN1: SW3.1 (A); also elsewhere on the board
/rp2040_peripherals/QSPI_CS: U3.56 (QSPI_SS); also elsewhere on the board
/rp2040_peripherals/QSPI_SCLK: U3.52 (QSPI_SCLK); also elsewhere on the board
/rp2040_peripherals/QSPI_SD1: U3.55 (QSPI_SD1); also elsewhere on the board
/rp2040_peripherals/QSPI_SD2: U3.54 (QSPI_SD2); also elsewhere on the board
/rp2040_peripherals/QSPI_SD3: U3.51 (QSPI_SD3); also elsewhere on the board
/rp2040_peripherals/QSPI_SDO: U3.53 (QSPI_SD0); also elsewhere on the board
/rp2040_peripherals/RESET: U3.26 (RUN); also elsewhere on the board
/rp2040_peripherals/SWCLK: U3.24 (SWCLK); also elsewhere on the board
/rp2040_peripherals/SWD: U3.25 (SWD); also elsewhere on the board
/rp2040_peripherals/XIN: U3.20 (XIN); also elsewhere on the board
/rp2040_peripherals/XOUT: U3.21 (XOUT); also elsewhere on the board
/ui_components/GPIO18: U3.29 (GPIO18); also elsewhere on the board
/ui_components/GPIO19: U3.30 (GPIO19); also elsewhere on the board
/ui_components/GPIO20: U3.31 (GPIO20); also elsewhere on the board
/ui_components/GPIO21: U3.32 (GPIO21); also elsewhere on the board
/ui_components/GPIO22: U3.34 (GPIO22); also elsewhere on the board
/ui_components/GPIO23: U3.35 (GPIO23); also elsewhere on the board
/ui_components/GPIO24: U3.36 (GPIO24); also elsewhere on the board
/ui_components/GPIO25: U3.37 (GPIO25); also elsewhere on the board
/ui_components/GPIO26: U3.38 (GPIO26_ADC0); also elsewhere on the board
/ui_components/GPIO27: U3.39 (GPIO27_ADC1); also elsewhere on the board
/ui_components/GPIO28: U3.40 (GPIO28_ADC2); also elsewhere on the board
/ui_components/GPIO29: U3.41 (GPIO29_ADC3); also elsewhere on the board
/ui_components/button1: U3.15 (GPIO12); also elsewhere on the board
/ui_components/button2: U3.16 (GPIO13); also elsewhere on the board
/ui_components/button3: U3.17 (GPIO14); also elsewhere on the board
/ui_components/button4: U3.18 (GPIO15); also elsewhere on the board
/ui_components/button5: U3.27 (GPIO16); also elsewhere on the board
/ui_components/button6: U3.28 (GPIO17); also elsewhere on the board
GND: BT1.2 (-), C1.2, C2.2, D13.1 (K), H2.1, H3.1, H4.1, TP_GND1.1, TP_GND2.1, TP_GND3.1, U1.1 (GND), U2.2 (gnd), U3.19 (TESTEN), U3.57 (GND); also elsewhere on the board
GNDA: C23.2, C24.2, C25.2, C26.2, C27.2, D5.1 (K), D12.1 (K), H1.1, J1.2, J2.2, TP_GNDA1.1, U2.1 (gnda), U6.2 (GND), U7.1 (GND_F), U7.2 (GND_S); also elsewhere on the board
unnamed: BT1.1 (+), SW3.5 (B)
unnamed: D5.2 (A), R21.2
unnamed: D12.2 (A), R16.2
unnamed: D13.2 (A), R17.2
unnamed: J1.1, SW3.2 (B)
unnamed: R7.2, U6.3 (CONTROL)
unnamed: R13.2, U7.3 (EN)
VREF: C25.1, R21.1, TP_VREF1.1, U7.5 (OUT_S), U7.6 (OUT_F); also elsewhere on the board

Notes on the sheet:
Microcontroller
Signal
Power
Utility

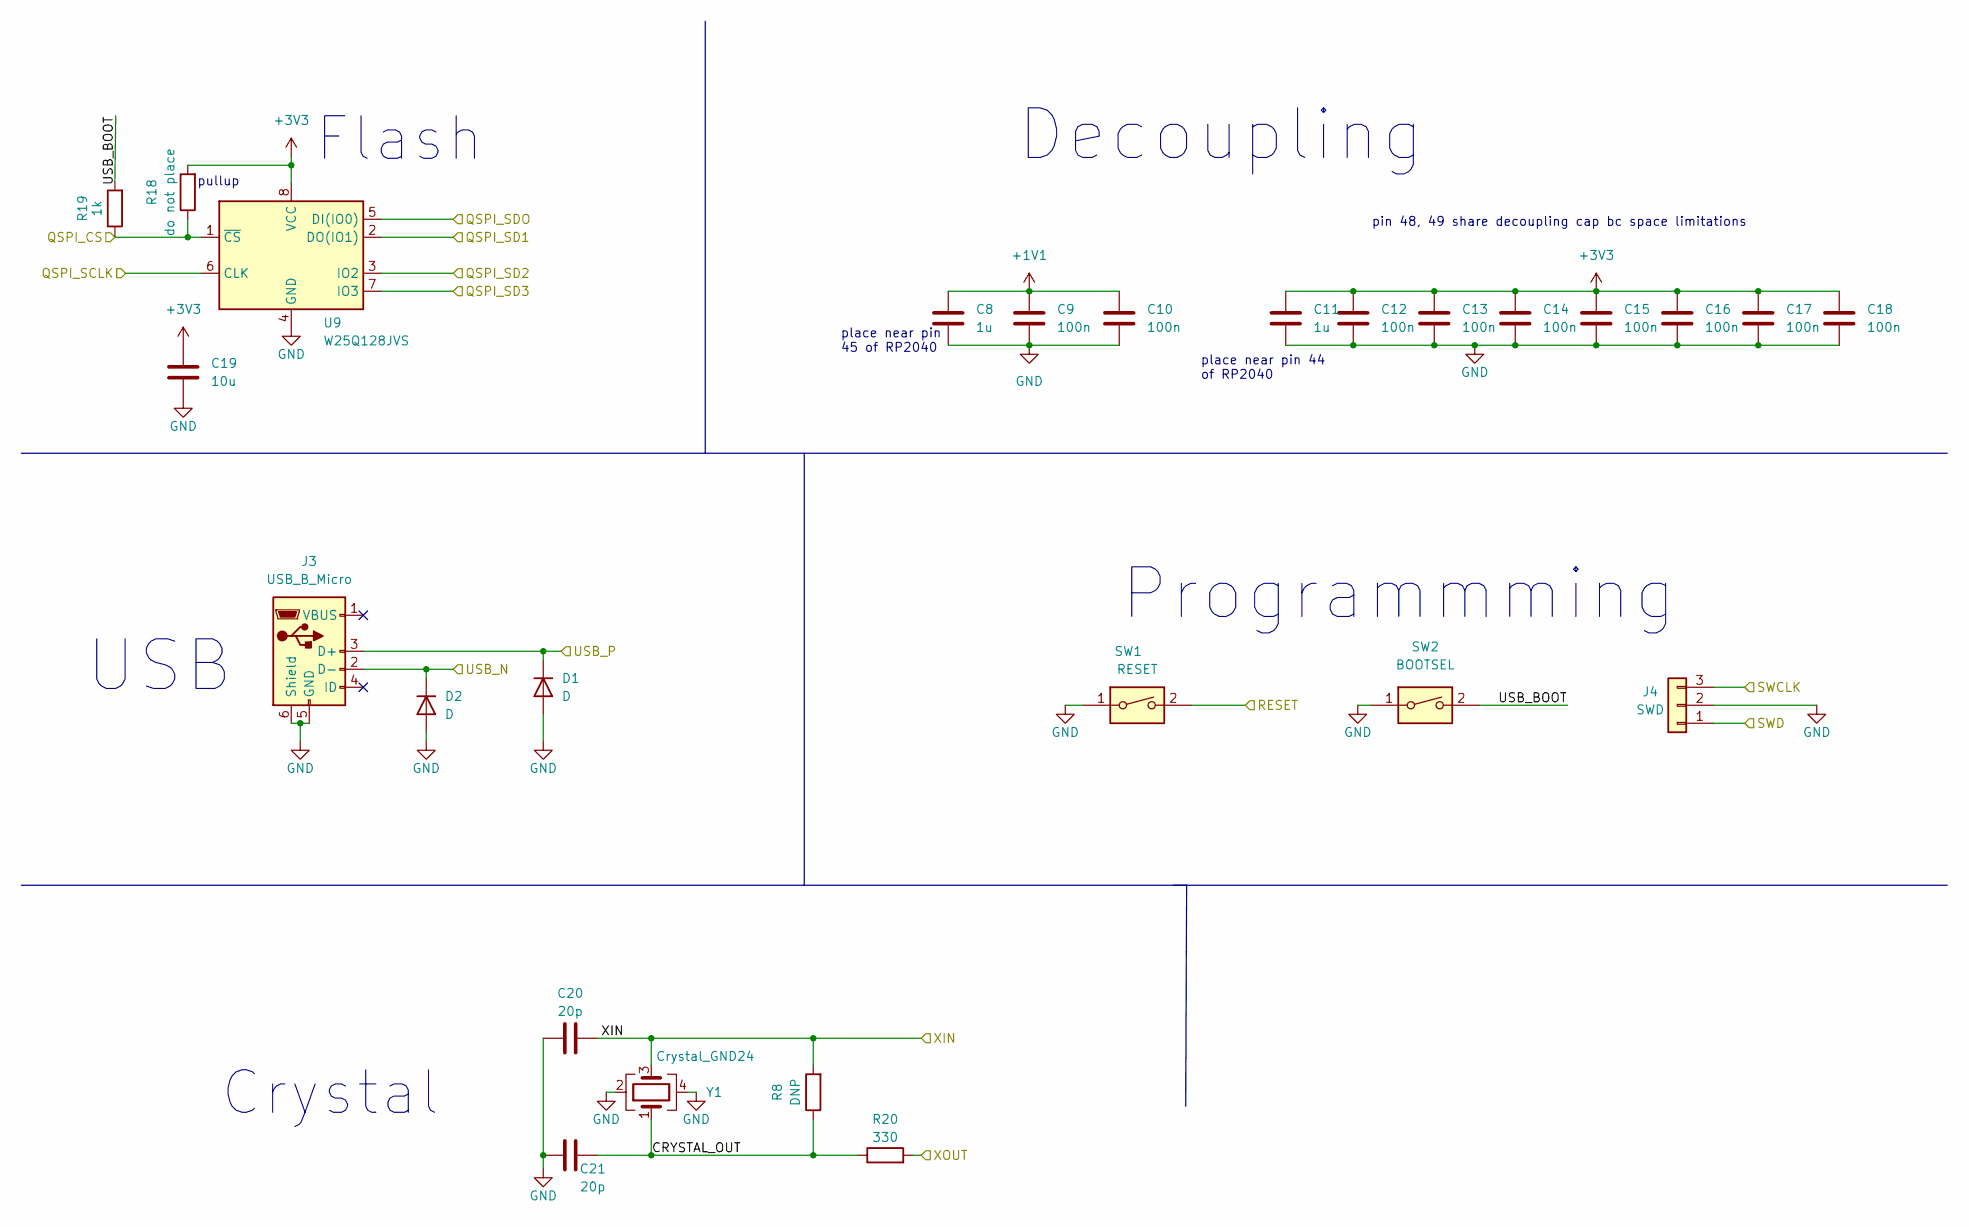
[picture p32: schematic rp2040_peripherals.kicad_sch, F.R.E.T. Board]

Parts:
C8, C11: 1u; C_0603_1608Metric
C9, C10, C12, C13, C14, C15, C16, C17, C18: 100n; C_0603_1608Metric
C19: 10u; C_0603_1608Metric
C20, C21: 20p; C_0603_1608Metric
D1, D2: D; D_0603_1608Metric
J3: USB_B_Micro; U254-051T-4BH83-S1S; LCSC Part Number C319160
J4: SWD; PinHeader_1x03_P2.54mm_Vertical
R8: DNP; R_0603_1608Metric
R18: do not place; R_0603_1608Metric
R19: 1k; R_0603_1608Metric
R20: 330; R_0603_1608Metric
SW1: RESET; PTS636 6.0x3.5 Button; LCSC Part Number C2800965
SW2: BOOTSEL; PTS636 6.0x3.5 Button; LCSC Part Number C2800965
U9: W25Q128JVS; SOIC-8_5.23x5.23mm_P1.27mm; LCSC Part Number C97521
Y1: Crystal_GND24; Crystal_SMD_2520-4Pin_2.5x2.0mm; LCSC Part Number C2686253

Connections:
+1V1: C8.1, C9.1, C10.1; also elsewhere on the board
/USB_DN: D2.1 (K), J3.2 (D-); also elsewhere on the board
/USB_DP: D1.1 (K), J3.3 (D+); also elsewhere on the board
/rp2040_peripherals/CRYSTAL_OUT: C21.1, R8.1, R20.1, Y1.1
/rp2040_peripherals/QSPI_CS: R18.1, R19.1, U9.1 (~CS); also elsewhere on the board
/rp2040_peripherals/QSPI_SCLK: U9.6 (CLK); also elsewhere on the board
/rp2040_peripherals/QSPI_SD1: U9.2 (DO(IO1)); also elsewhere on the board
/rp2040_peripherals/QSPI_SD2: U9.3 (IO2); also elsewhere on the board
/rp2040_peripherals/QSPI_SD3: U9.7 (IO3); also elsewhere on the board
/rp2040_peripherals/QSPI_SDO: U9.5 (DI(IO0)); also elsewhere on the board
/rp2040_peripherals/RESET: SW1.2; also elsewhere on the board
/rp2040_peripherals/SWCLK: J4.3; also elsewhere on the board
/rp2040_peripherals/SWD: J4.1; also elsewhere on the board
/rp2040_peripherals/USB_BOOT: R19.2, SW2.2
/rp2040_peripherals/XIN: C20.1, R8.2, Y1.3; also elsewhere on the board
/rp2040_peripherals/XOUT: R20.2; also elsewhere on the board
GND: C8.2, C9.2, C10.2, C11.2, C12.2, C13.2, C14.2, C15.2, C16.2, C17.2, C18.2, C19.2, C20.2, C21.2, D1.2 (A), D2.2 (A), J3.5 (GND), J3.6 (Shield), J4.2, SW1.1, SW2.1, U9.4 (GND), Y1.2, Y1.4; also elsewhere on the board

Notes on the sheet:
pullup
Flash
Crystal
place near pin 44 of RP2040
USB
Decoupling
place near pin 45 of RP2040
pin 48, 49 share decoupling cap bc space limitations
Programmming

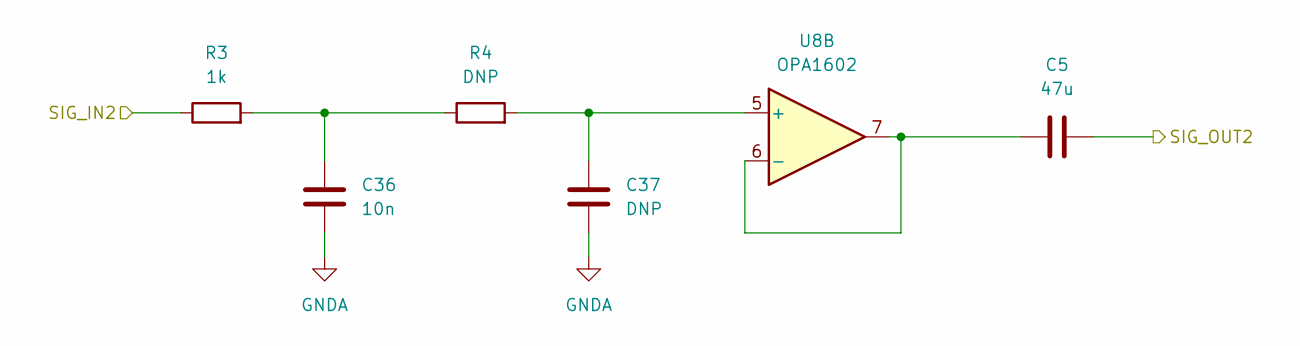
[picture p33: schematic output_filter.kicad_sch, F.R.E.T. Board]

Parts:
C5: 47u; C_1210_3225Metric
C36: 10n; C_0603_1608Metric
C37: DNP; C_0603_1608Metric
R3: 1k; R_0603_1608Metric
R4: DNP; R_0603_1608Metric
U8: OPA1602; OPA1602AIDR

Connections:
/DAC/S_OUT: R3.1; also elsewhere on the board
/SIG_OUT: C5.2; also elsewhere on the board
GNDA: C36.2, C37.2; also elsewhere on the board
unnamed: C5.1, U8.6 (-), U8.7
unnamed: C36.1, R3.2, R4.1
unnamed: C37.1, R4.2, U8.5 (+)

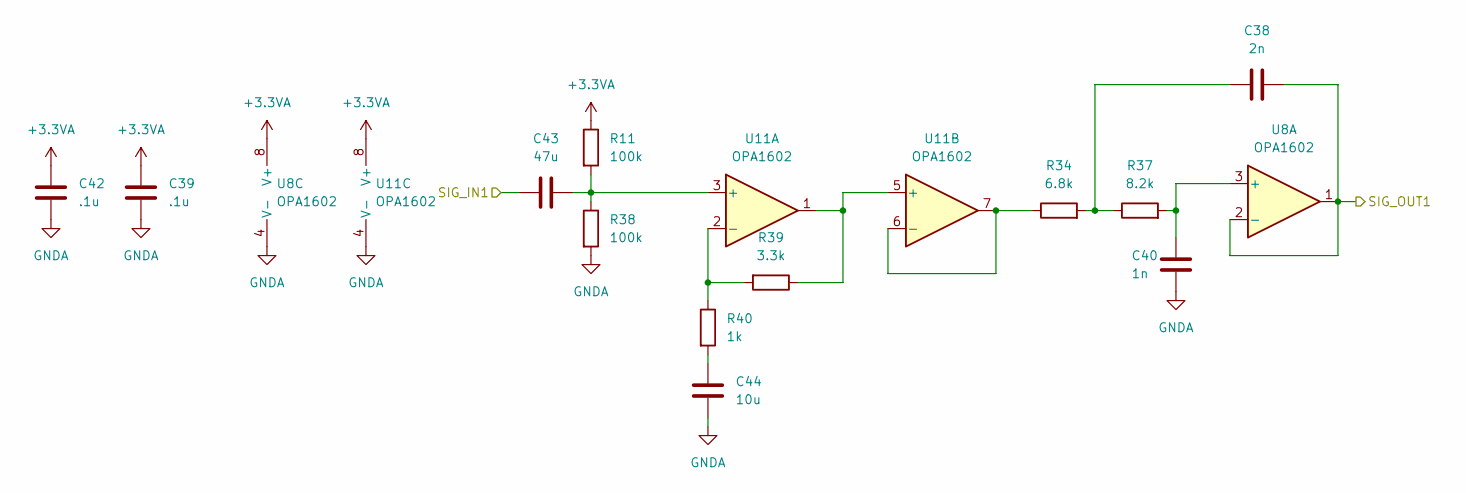
[picture p34: schematic input_filter.kicad_sch, F.R.E.T. Board]

Parts:
C38: 2n; C_0603_1608Metric
C39, C42: .1u; C_0603_1608Metric
C40: 1n; C_0603_1608Metric
C43: 47u; C_1210_3225Metric
C44: 10u; C_0603_1608Metric
R11, R38: 100k; R_0603_1608Metric
R34: 6.8k; R_0603_1608Metric
R37: 8.2k; R_0603_1608Metric
R39: 3.3k; R_0603_1608Metric
R40: 1k; R_0603_1608Metric
U8, U11: OPA1602; OPA1602AIDR

Connections:
+3.3VA: C39.1, C42.1, R11.1, U8.8 (V+), U11.8 (V+); also elsewhere on the board
/ADC/SIG_IN_ADC: C38.2, U8.1, U8.2 (-); also elsewhere on the board
/input_filter/SIG_IN1: C43.1; also elsewhere on the board
GNDA: C39.2, C40.1, C42.2, C44.1, R38.2, U8.4 (V-), U11.4 (V-); also elsewhere on the board
unnamed: C38.1, R34.2, R37.1
unnamed: C40.2, R37.2, U8.3 (+)
unnamed: C43.2, R11.2, R38.1, U11.3 (+)
unnamed: C44.2, R40.2
unnamed: R34.1, U11.6 (-), U11.7
unnamed: R39.1, U11.1, U11.5 (+)
unnamed: R39.2, R40.1, U11.2 (-)

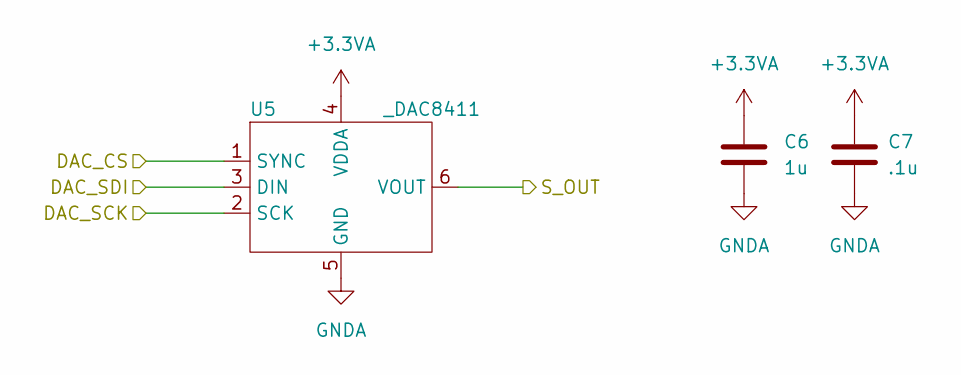
[picture p35: schematic dac.kicad_sch, F.R.E.T. Board]

Parts:
C6: 1u; C_0603_1608Metric
C7: .1u; C_0603_1608Metric
U5: _DAC8411; Texas_R-PDSO-G6; LCSC Part Number C2926925

Connections:
+3.3VA: C6.1, C7.1, U5.4 (VDDA); also elsewhere on the board
/DAC/S_OUT: U5.6 (VOUT); also elsewhere on the board
/DAC_CS: U5.1 (SYNC); also elsewhere on the board
/SPI0_SCK: U5.2 (SCK); also elsewhere on the board
/SPI0_SDI: U5.3 (DIN); also elsewhere on the board
GNDA: C6.2, C7.2, U5.5 (GND); also elsewhere on the board

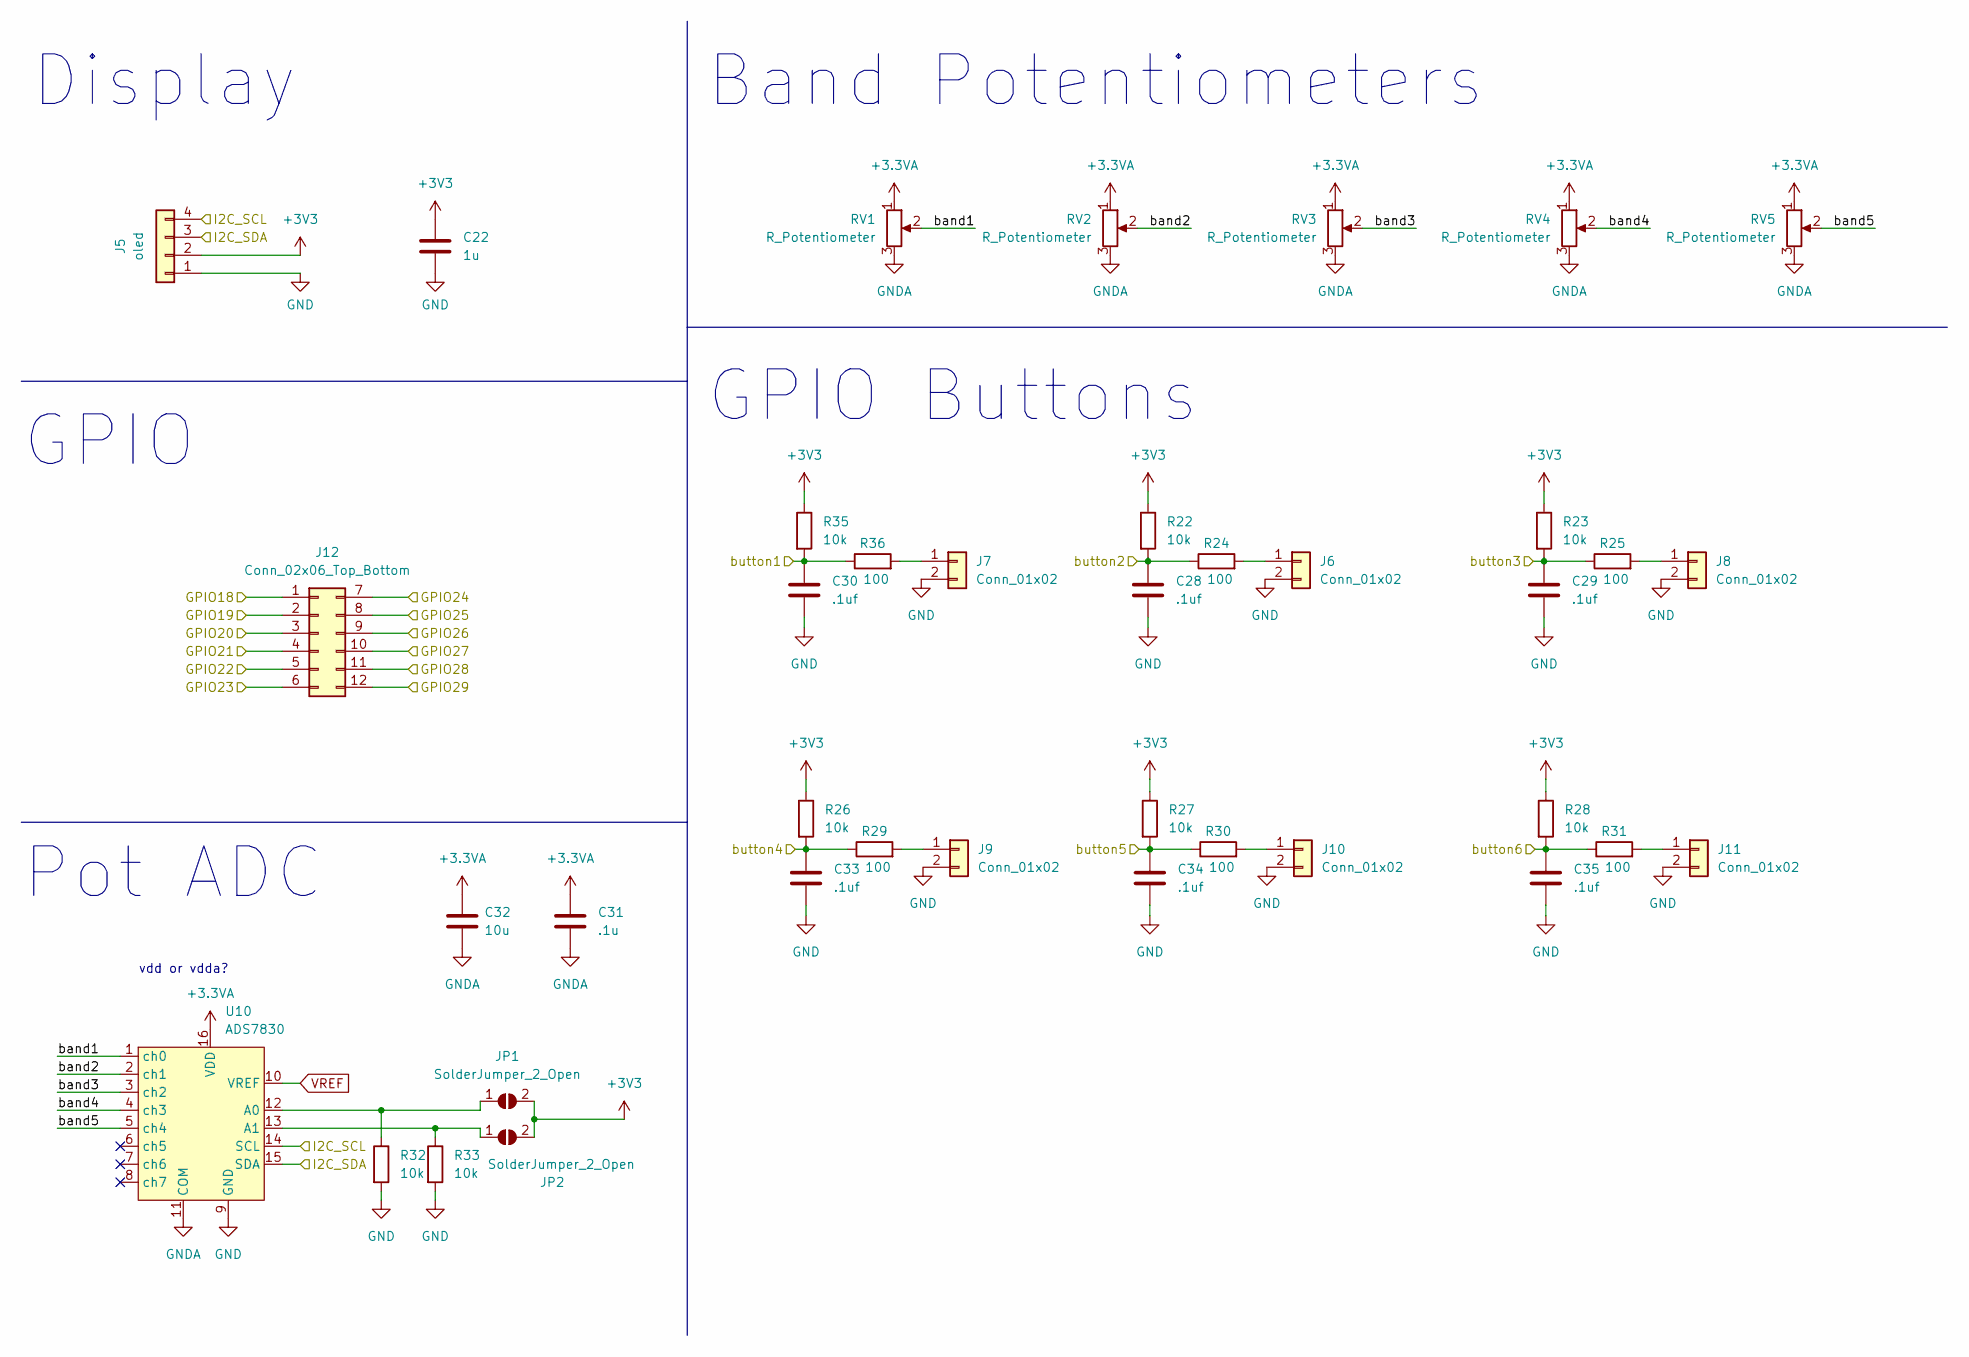
[picture p36: schematic ui_components.kicad_sch, F.R.E.T. Board]

Parts:
C22: 1u; C_0603_1608Metric
C28, C29, C30, C33, C34, C35: .1uf; C_0603_1608Metric
C31: .1u; C_0603_1608Metric
C32: 10u; C_0603_1608Metric
J5: oled; PinHeader_1x04_P2.54mm_Vertical
J6, J7, J8, J9, J10, J11: Conn_01x02; PinHeader_1x02_P2.54mm_Vertical
J12: Conn_02x06_Top_Bottom; PinHeader_2x06_P2.54mm_Vertical
JP1, JP2: SolderJumper_2_Open; SolderJumper-2_P1.3mm_Open_TrianglePad1.0x1.5mm
R22, R23, R26, R27, R28, R32, R33, R35: 10k; R_0603_1608Metric
R24, R25, R29, R30, R31, R36: 100; R_0603_1608Metric
RV1, RV2, RV3, RV4, RV5: R_Potentiometer; PS30-10PB1BR10K
U10: ADS7830; PW16; LCSC Part Number C161747

Connections:
+3.3VA: C31.1, C32.1, RV1.1, RV2.1, RV3.1, RV4.1, RV5.1, U10.16 (VDD); also elsewhere on the board
/I2C0_SCL: J5.4, U10.14 (SCL); also elsewhere on the board
/I2C0_SDA: J5.3, U10.15 (SDA); also elsewhere on the board
/ui_components/GPIO18: J12.1; also elsewhere on the board
/ui_components/GPIO19: J12.2; also elsewhere on the board
/ui_components/GPIO20: J12.3; also elsewhere on the board
/ui_components/GPIO21: J12.4; also elsewhere on the board
/ui_components/GPIO22: J12.5; also elsewhere on the board
/ui_components/GPIO23: J12.6; also elsewhere on the board
/ui_components/GPIO24: J12.7; also elsewhere on the board
/ui_components/GPIO25: J12.8; also elsewhere on the board
/ui_components/GPIO26: J12.9; also elsewhere on the board
/ui_components/GPIO27: J12.10; also elsewhere on the board
/ui_components/GPIO28: J12.11; also elsewhere on the board
/ui_components/GPIO29: J12.12; also elsewhere on the board
/ui_components/band1: RV1.2, U10.1 (ch0)
/ui_components/band2: RV2.2, U10.2 (ch1)
/ui_components/band3: RV3.2, U10.3 (ch2)
/ui_components/band4: RV4.2, U10.4 (ch3)
/ui_components/band5: RV5.2, U10.5 (ch4)
/ui_components/button1: C30.1, R35.2, R36.1; also elsewhere on the board
/ui_components/button2: C28.1, R22.2, R24.1; also elsewhere on the board
/ui_components/button3: C29.1, R23.2, R25.1; also elsewhere on the board
/ui_components/button4: C33.1, R26.2, R29.1; also elsewhere on the board
/ui_components/button5: C34.1, R27.2, R30.1; also elsewhere on the board
/ui_components/button6: C35.1, R28.2, R31.1; also elsewhere on the board
GND: C22.2, C28.2, C29.2, C30.2, C33.2, C34.2, C35.2, J5.1, J6.2, J7.2, J8.2, J9.2, J10.2, J11.2, R32.2, R33.2, U10.9 (GND); also elsewhere on the board
GNDA: C31.2, C32.2, RV1.3, RV2.3, RV3.3, RV4.3, RV5.3, U10.11 (COM); also elsewhere on the board
unnamed: J6.1, R24.2
unnamed: J7.1, R36.2
unnamed: J8.1, R25.2
unnamed: J9.1, R29.2
unnamed: J10.1, R30.2
unnamed: J11.1, R31.2
unnamed: JP1.1 (A), R32.1, U10.12 (A0)
unnamed: JP2.1 (A), R33.1, U10.13 (A1)
VREF: U10.10 (VREF); also elsewhere on the board

Notes on the sheet:
vdd or vdda?
Display
GPIO
Band Potentiometers
Pot ADC
GPIO Buttons

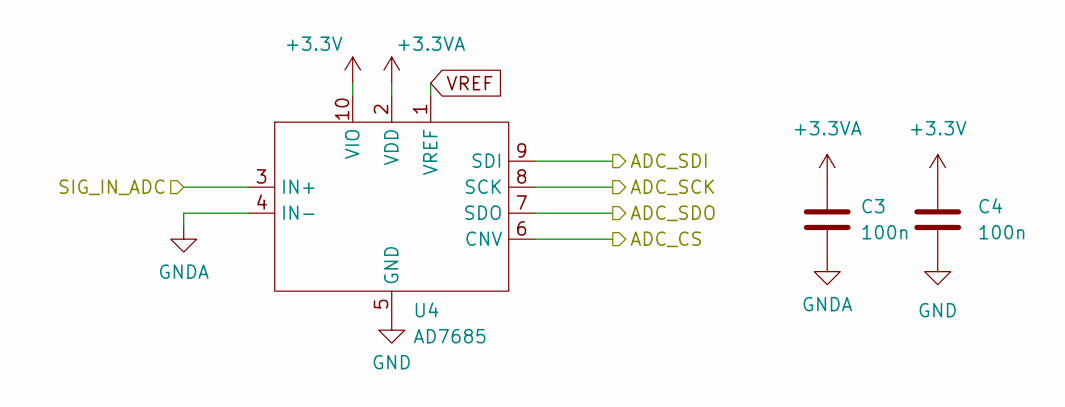
[picture p37: schematic untitled.kicad_sch, F.R.E.T. Board]

Parts:
C3, C4: 100n; C_0603_1608Metric
U4: AD7685; MSOP-10_3x3mm_P0.5mm; LCSC Part Number C44637

Connections:
+3.3VA: C3.1, U4.2 (VDD); also elsewhere on the board
/ADC/SIG_IN_ADC: U4.3 (IN+); also elsewhere on the board
/ADC_CS: U4.6 (CNV); also elsewhere on the board
/SPI0_SCK: U4.8 (SCK); also elsewhere on the board
/SPI0_SDI: U4.9 (SDI); also elsewhere on the board
/SPI0_SDO: U4.7 (SDO); also elsewhere on the board
GND: C4.2, U4.5 (GND); also elsewhere on the board
GNDA: C3.2, U4.4 (IN-); also elsewhere on the board
VREF: U4.1 (VREF); also elsewhere on the board

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
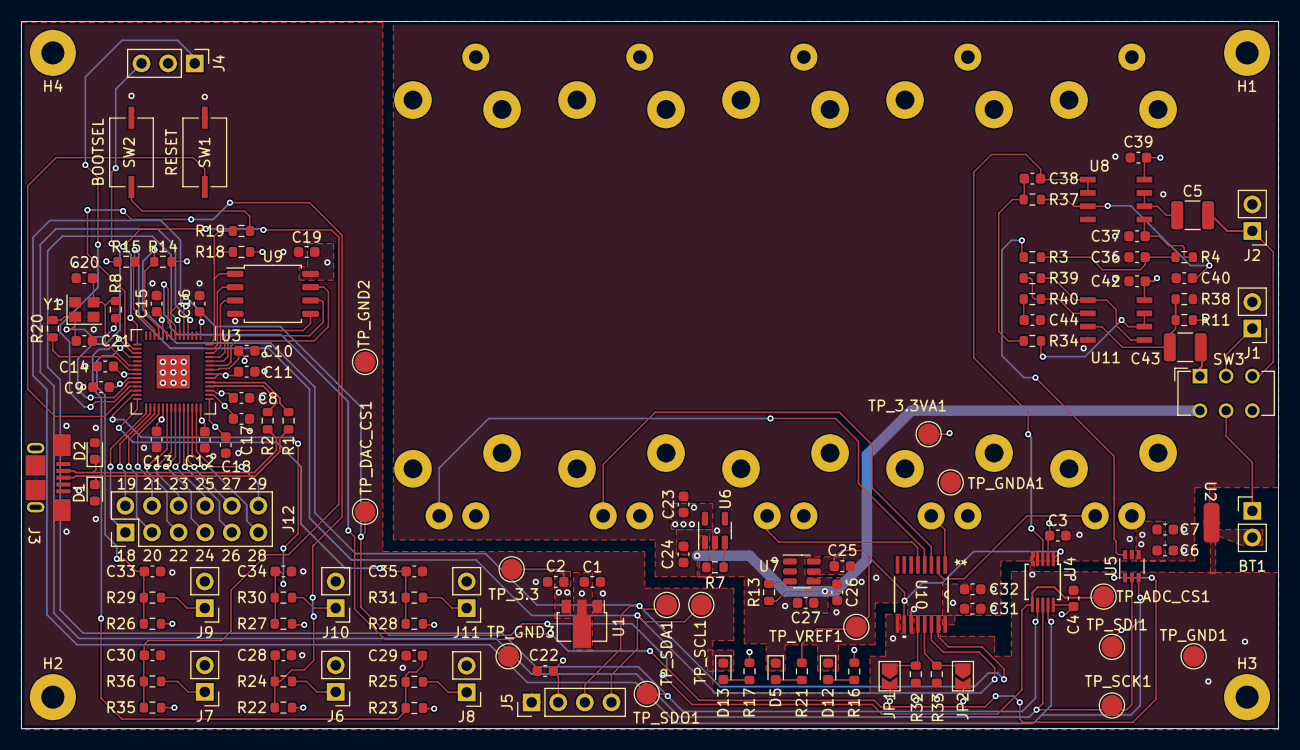
[picture p38: board v1.kicad_pcb from above]

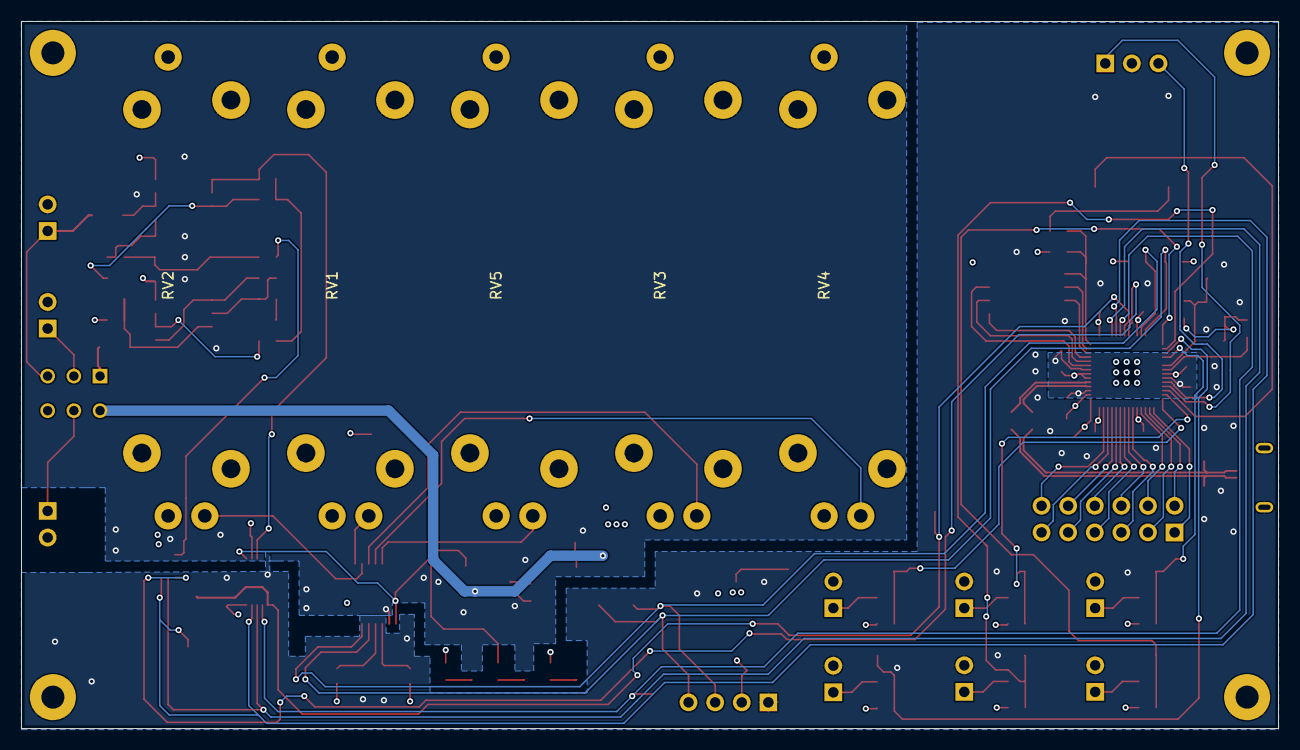
[picture p39: board v1.kicad_pcb from below]

Board: 4 copper layers, 120.0 x 67.5 mm, 136 parts (5 on the bottom side), 83 nets.
