JHorwitz1011/F.R.E.T.-Board/code/examples/multicore_i2c/pins.h

#pragma once

//spi
#define MOSI 4
#define SCK  2
#define MISO 3

//i2c
#define SDA 8
#define SCL 9

#define CS_AD7685 5
#define CS_DAC8411 6

#define UTIL1 18
#define UTIL2 19
#define UTIL3 20
#define UTIL4 21
#define UTIL5 22
#define UTIL6 23
#define UTIL7 24
#define UTIL8 25
#define UTIL9 26
#define UTIL10 27
#define UTIL11 28
#define UTIL12 29
