JHorwitz1011/F.R.E.T.-Board/(commit log)

2023-10-06 board done;
    [v1.kicad_pcb, v1.kicad_sch]
2023-10-24 code folder
    [v1.kicad_pcb, v1.kicad_sch]
2023-10-24 code added
    [amplifier.kicad_sch, dac.kicad_sch, fretbom_v2.csv, input_amplifier.kicad_sch, input_filter.kicad_sch, inputlpf.kicad_sch, output_amplifier.kicad_sch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]
2023-10-31 dac and adc examples written
    [amplifier.kicad_sch, dac.kicad_sch, fretbom_v2.csv, input_amplifier.kicad_sch, input_filter.kicad_sch, inputlpf.kicad_sch, output_amplifier.kicad_sch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]
2023-11-17 worked on architecture and filtering
2023-11-17 filtering work
2023-11-17 updated filtering
2023-11-18 i2c adc pushed
2023-11-24 reworking fixed point filtering. see examples/filtering
    [filters.c, filters.h, main.c]
2023-11-24 uint to fixed and fixed to uint work. all thats left is to test multiply functionality
    [filters.c, filters.h, main.c]
2023-11-26 filters testing rig setup
2023-11-26 testing rig setup for filters
2023-11-26 filter test rig
2023-11-27 main created
    [output.csv]
2023-11-29 filtering work again
    [output.csv]
2023-12-03 AHHHHHHHHHH (filtering works fixed indice errors
    [output.csv]
2023-12-03 pus hfor peter
    [output.csv]
2023-12-03 refactored filters
2023-12-06 filtering function succesfully mixing with gains
    [output.csv]
2023-12-06 sfint dac and adc works
2023-12-06 i2c sliders work
